derekfountain/z88-recreation/README.md

# z88-recreation
A recreation of the 1980's Z88 micro, using modern components
