derekfountain/z88-recreation/software/application-board/app-board-sh1106-pico2/README.md

# Application Board Pico2 Demo (SH1106 version)

A demonstration program for the application board, displays information on Pico2.

This assumes the Pico it's running on is connected to a SH1106-based OLED display.
