derekfountain/z88-recreation/software/application-board/app-board-demo-ssd1306-oled/README.md

# Application Board OLED Demo (SH1106 version)

A demonstration program for the application board.

This assumes the Pico it's running on is connected to
a SSD1306-based OLED display.

It turned out my displays are SH1106 based, so this code
was never used. I don't know if it works.
