derekfountain/z88-recreation/hardware/pcb/main-board/notebook.txt

This is the simulation of the dual shifts, RTC and
Pico latch inputs which power up the Pico's power circuit.
 
https://www.falstad.com/circuit/circuitjs.html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
