derekfountain/z88-recreation/documents/pcb_design/v1.0_block_design.pdf

Clicky beeper, proper audio is out via 3.5mm socket

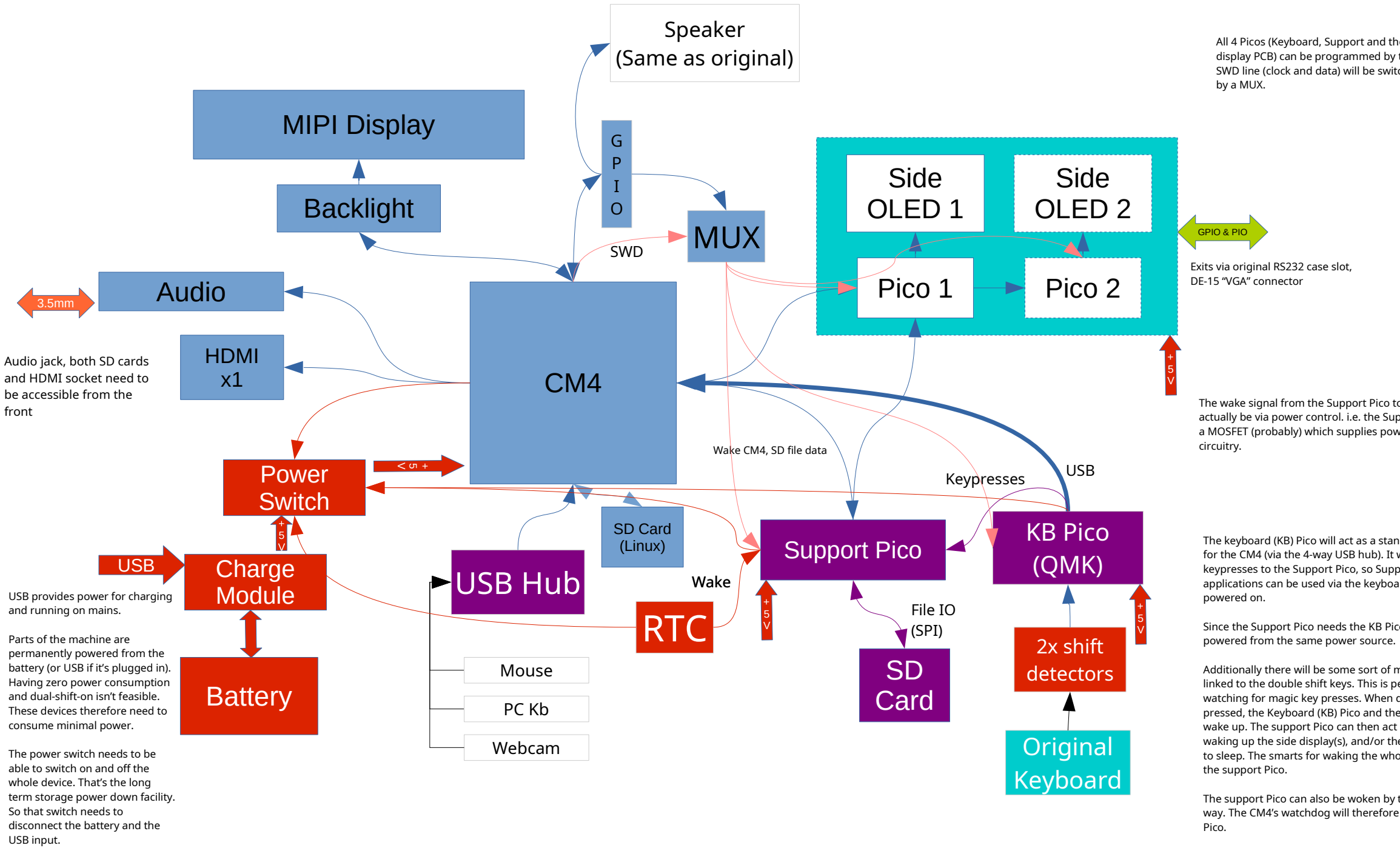
[picture p13: figure]
Support Pico; GPIO & PIO; Audio; SD Card; HDMI x1; Charge Module; USB; Battery; RTC; USB Hub; Original Keyboard; KB Pico (QMK); 2x shift detectors; Speaker (Same as original); Exits via original RS232 case slot, DE-15 “VGA” connector; USB provides power for charging and running on mains.; Parts of the machine are permanently powered from the battery (or USB if it’s plugged in). Having zero power consumption and dual-shift-on isn’t feasible. These devices therefore need to consume minimal power.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

All 4 Picos (Keyboard, Support and the optional 2 in the display PCB) can be programmed by the CM4 via SWD. The 2 SWD line (clock and data) will be switched one of four ways

The keyboard (KB) Pico will act as a standard USB keyboard for the CM4 (via the 4-way USB hub). It will also supply keypresses to the Support Pico, so Support Pico based applications can be used via the keyboard without the CM4

Since the Support Pico needs the KB Pico, they can be

Additionally there will be some sort of main power switch linked to the double shift keys. This is permanently powered, watching for magic key presses. When double shift is pressed, the Keyboard (KB) Pico and the Support Pico will wake up. The support Pico can then act as necessary, either waking up the side display(s), and/or the CM4, or going back to sleep. The smarts for waking the whole system up are in

The support Pico can also be woken by the RTC in the same way. The CM4’s watchdog will therefore be via the support

Red denotes permanent power. This comes from the USB connection or the battery, into the charge module. Real time clock and the dual shift detection is permanently powered.

Blue denotes CM4 power. These devices power up when the CM4 is in use.

Purple denotes Support Pico power. These devices power up when the support Pico is in use.

The wake signal from the Support Pico to the CM4 will actually be via power control. i.e. the Support Pico will switch a MOSFET (probably) which supplies power to the CM4
