derekfountain/z88-recreation/images/original/pcb_front_1.png

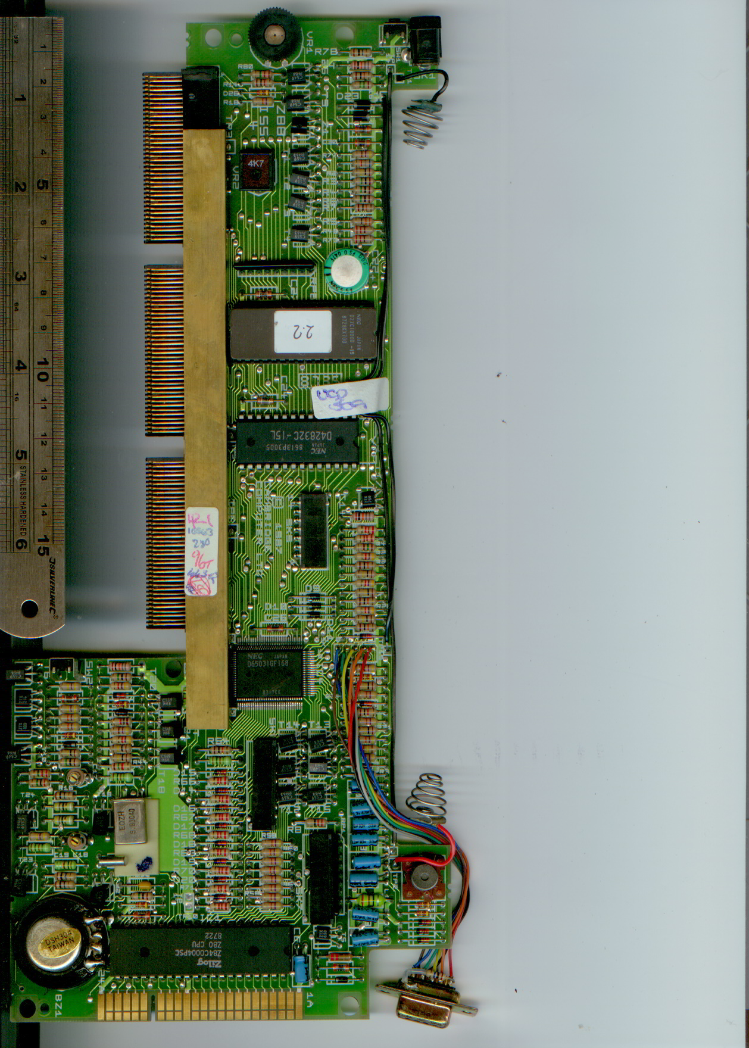
images/original/pcb_front_1.png
