derekfountain/z88-recreation/images/original/pcb_front_2.png

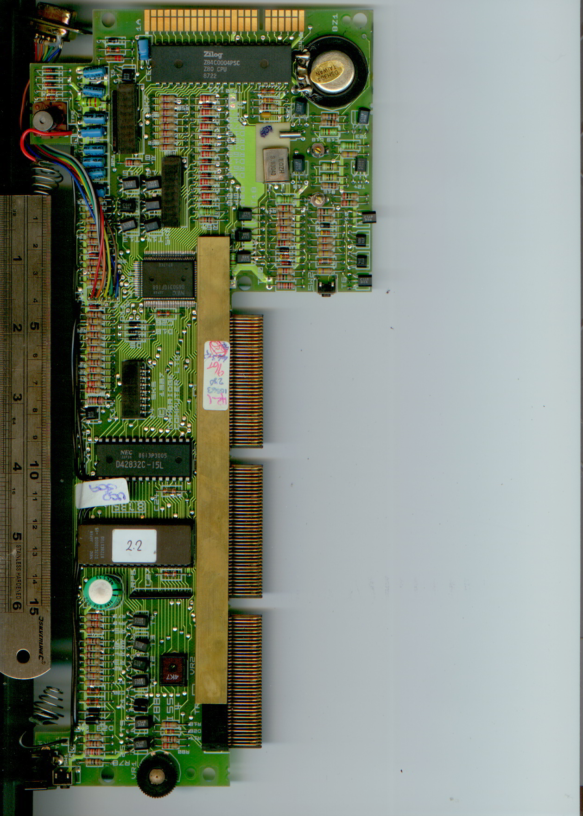
images/original/pcb_front_2.png
