derekfountain/z88-recreation/images/original/pcb_rear_1.png

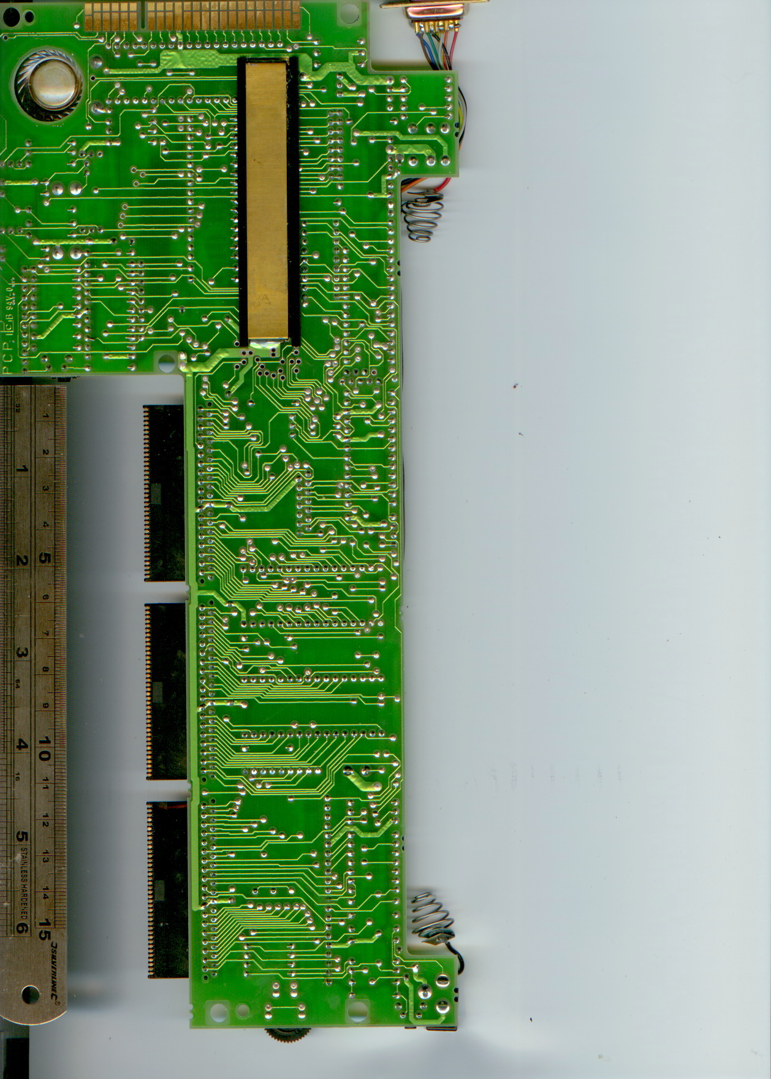
images/original/pcb_rear_1.png
