derekfountain/z88-recreation/images/original/pcb_rear_2.png

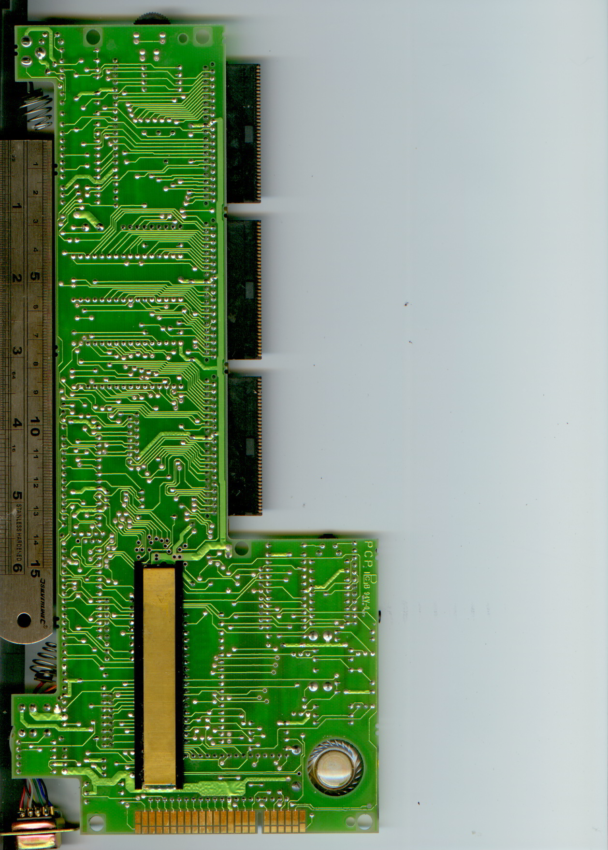
images/original/pcb_rear_2.png
