derekfountain/z88-recreation/images/v1.0/200_pin_connector.jpg

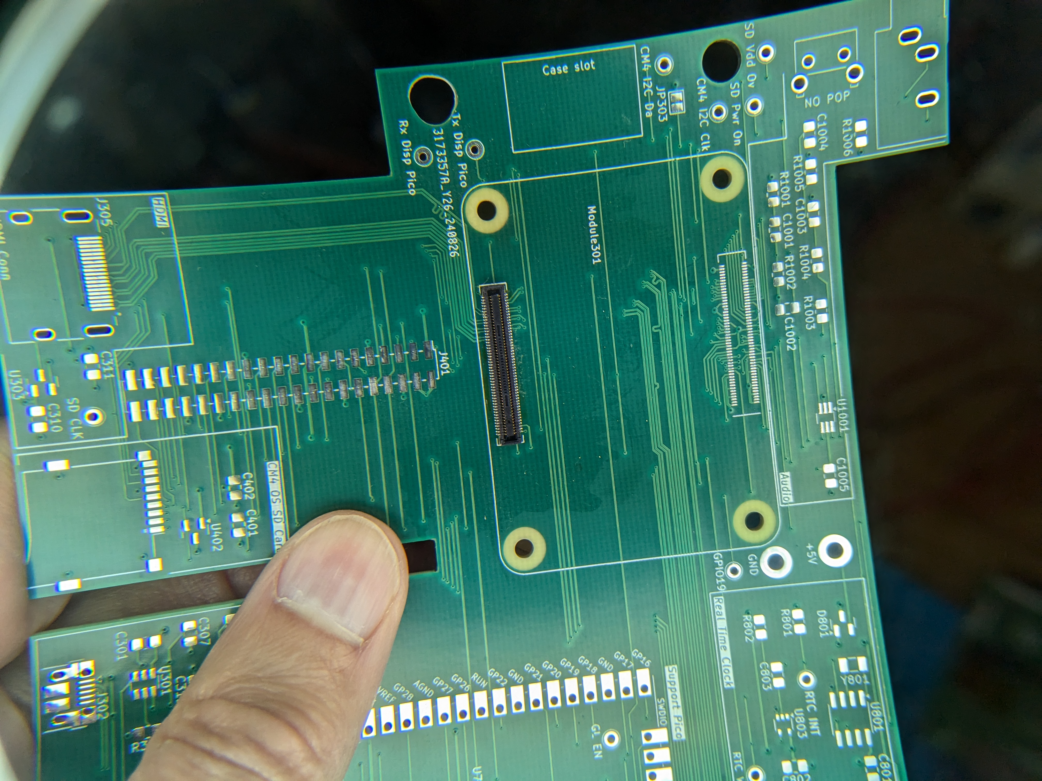
images/v1.0/200_pin_connector.jpg
