derekfountain/z88-recreation/images/v1.0/first_mipi.jpg

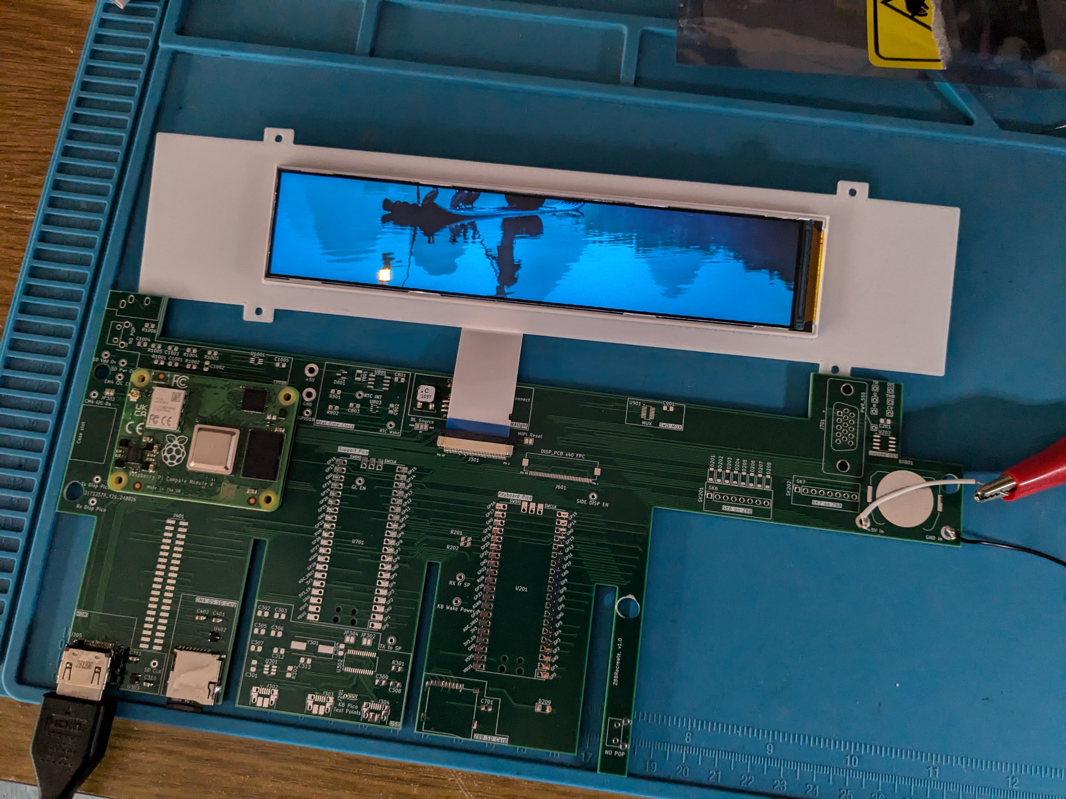
images/v1.0/first_mipi.jpg
