derekfountain/z88-recreation/images/v1.0/front_connectors.jpg

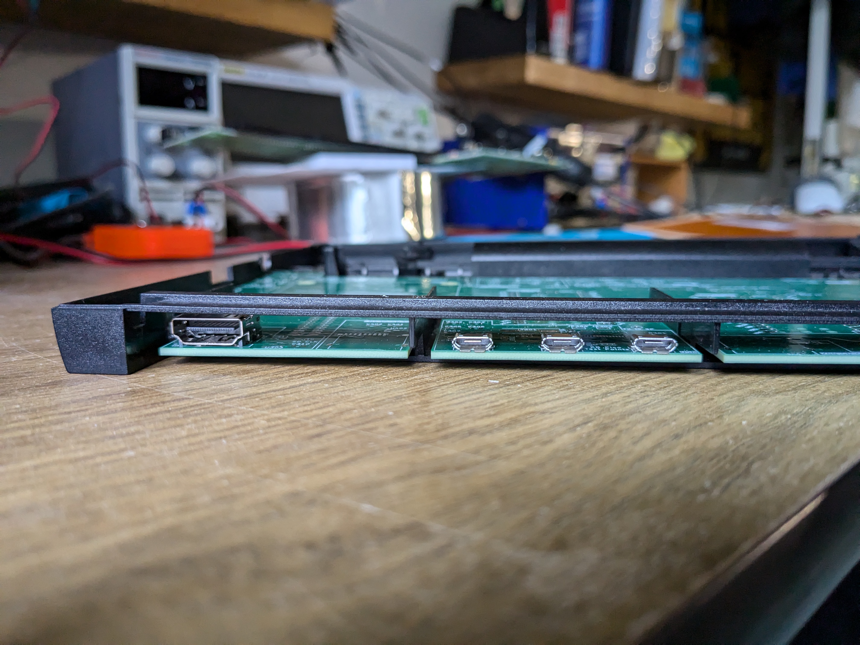
images/v1.0/front_connectors.jpg
