derekfountain/z88-recreation/images/v1.0/long_tail_membrane_in_place.jpg

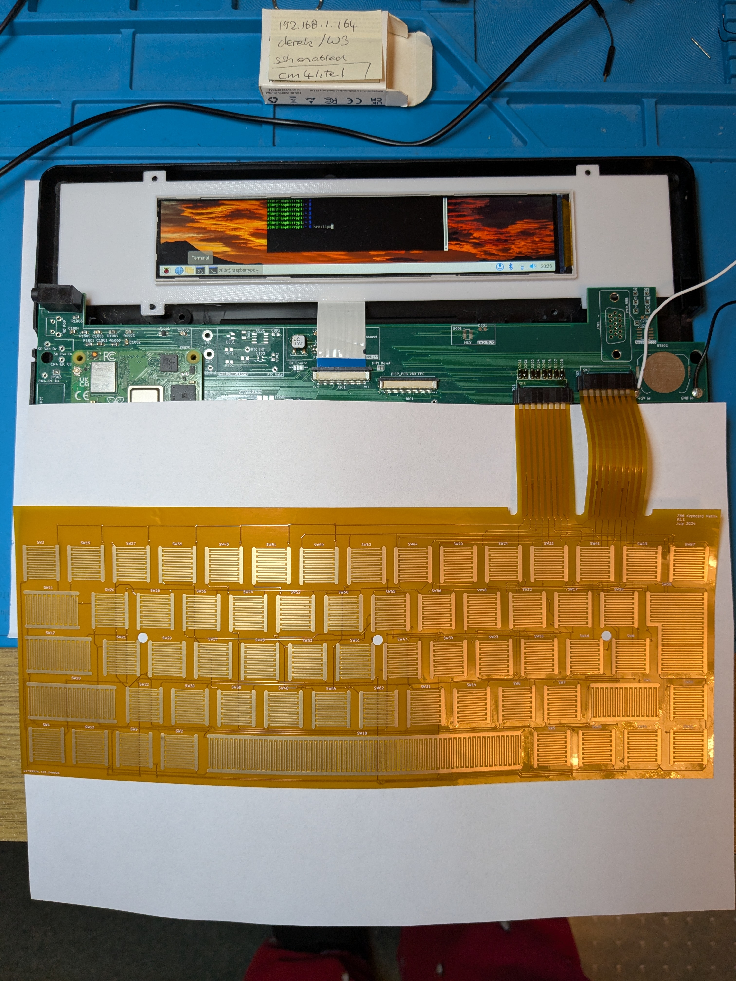
images/v1.0/long_tail_membrane_in_place.jpg
