derekfountain/z88-recreation/images/v1.0/mipi_with_new_bezel.jpg

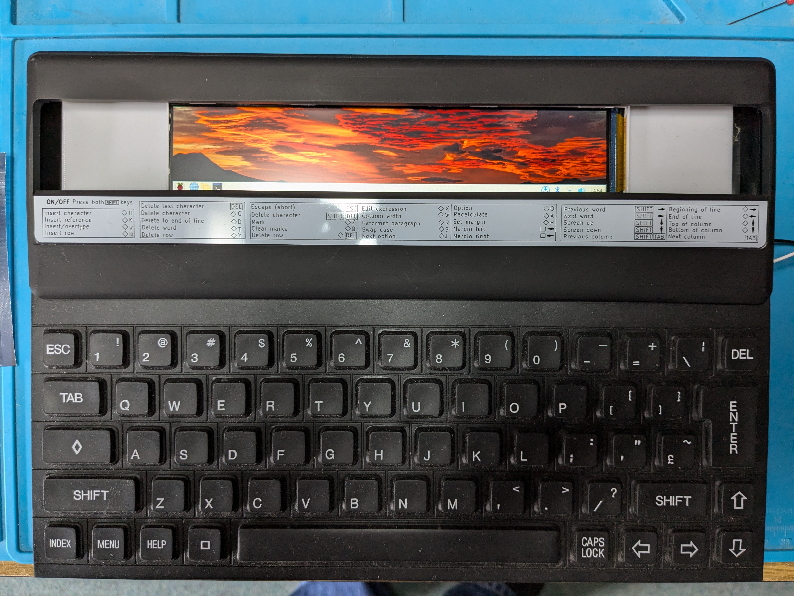
images/v1.0/mipi_with_new_bezel.jpg
