derekfountain/z88-recreation/images/v1.0/mipi_with_original_bezel.jpg

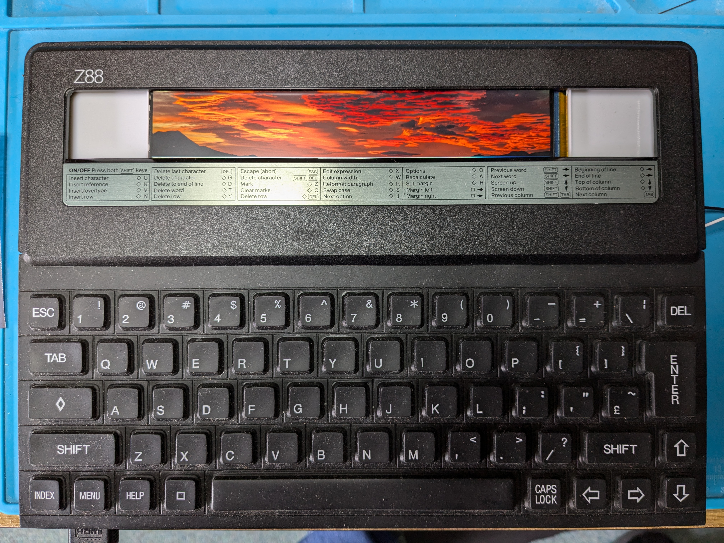
images/v1.0/mipi_with_original_bezel.jpg
