derekfountain/z88-recreation/images/v1.0/pico_in_place.jpg

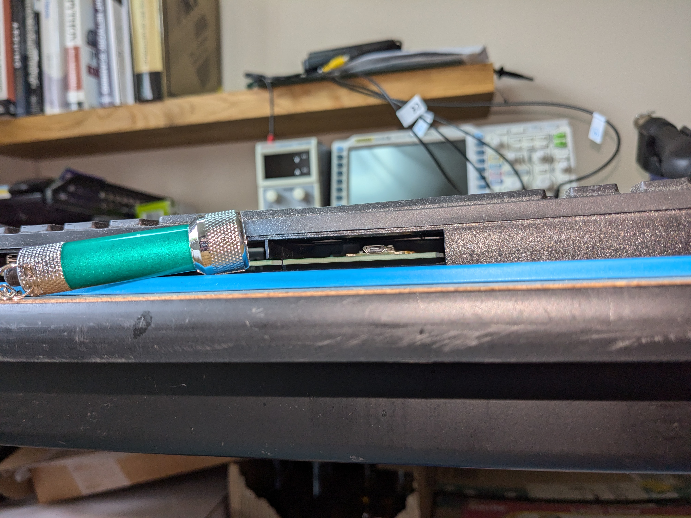
images/v1.0/pico_in_place.jpg
