derekfountain/z88-recreation/images/v1.0/v10_board_misalign_left.jpg

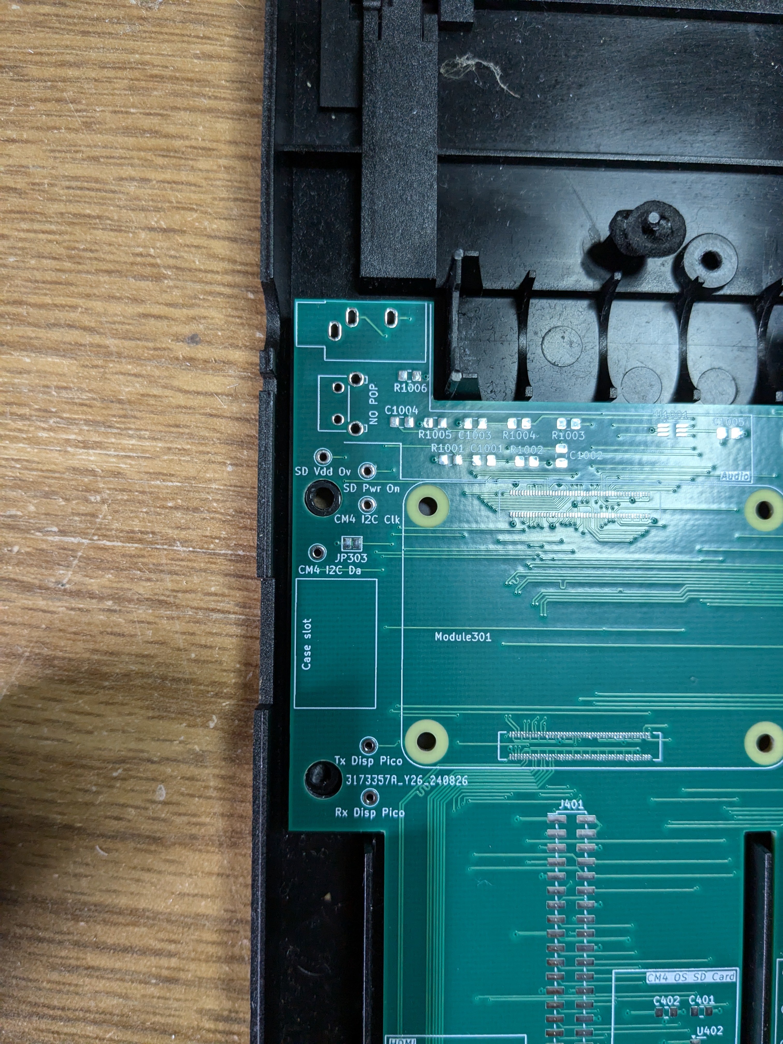
images/v1.0/v10_board_misalign_left.jpg
