derekfountain/z88-recreation/images/v1.0/v10_boards_packaged.jpg

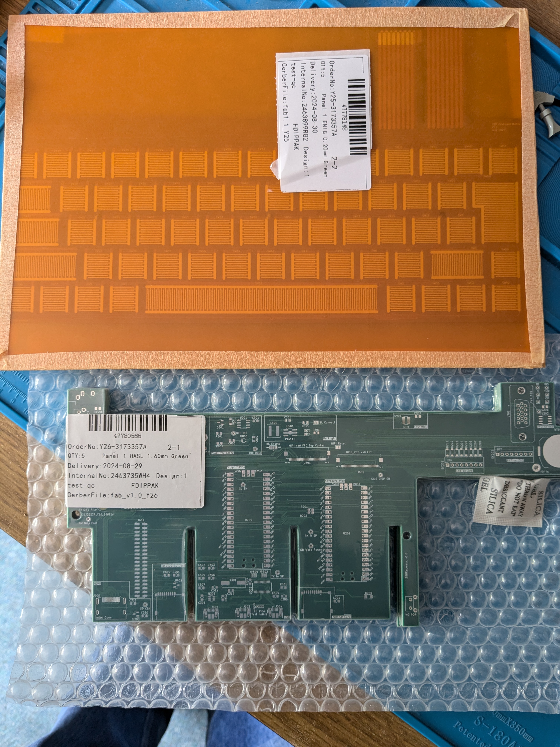
images/v1.0/v10_boards_packaged.jpg
