derekfountain/z88-recreation/images/v1.0/working_hdmi.jpg

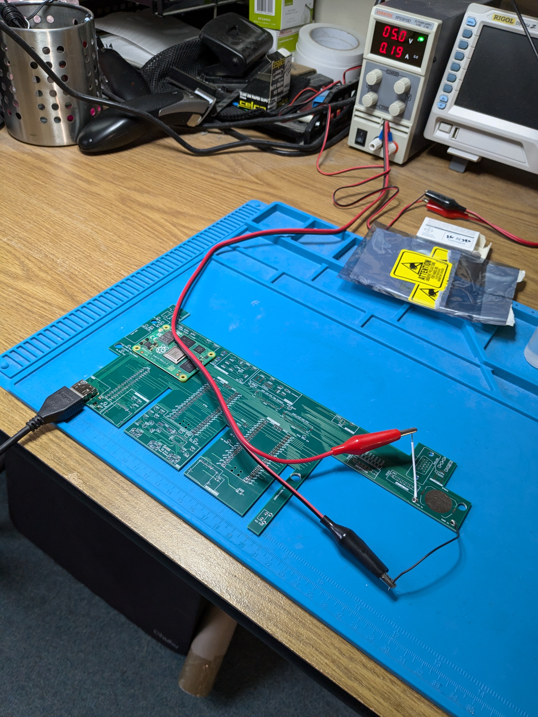
images/v1.0/working_hdmi.jpg
