derekfountain/z88-recreation/images/misc/am_cm4_display_order.png

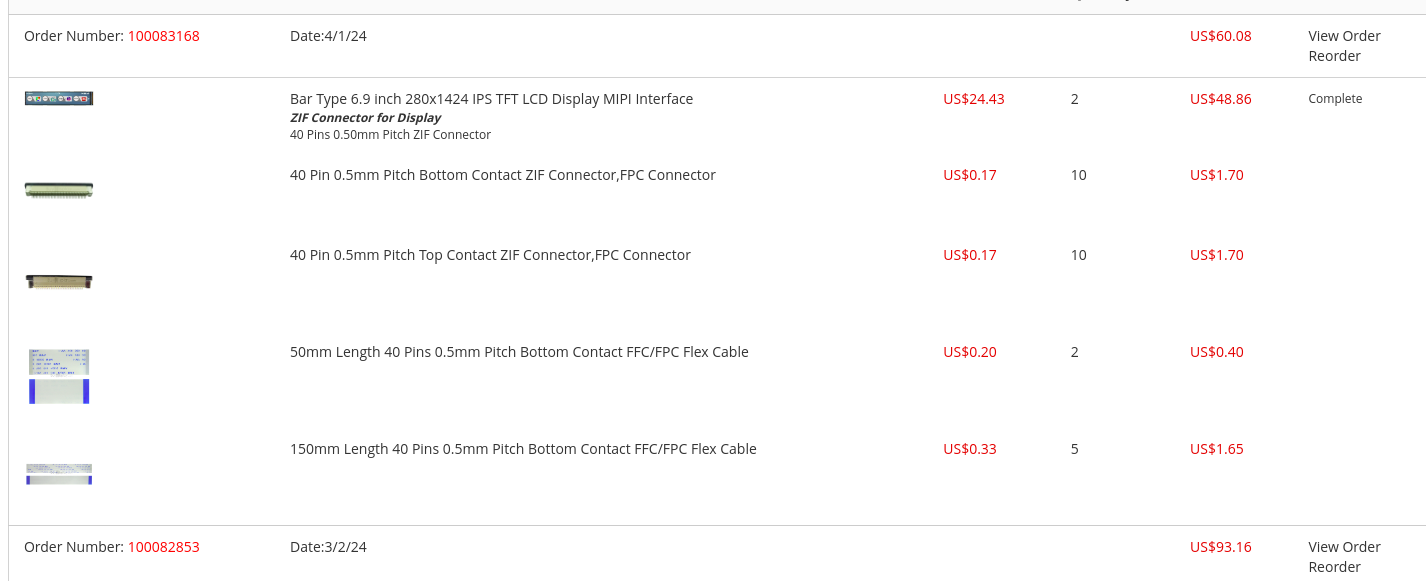
images/misc/am_cm4_display_order.png
