derekfountain/z88-recreation/images/misc/df_cm4_display_order.png

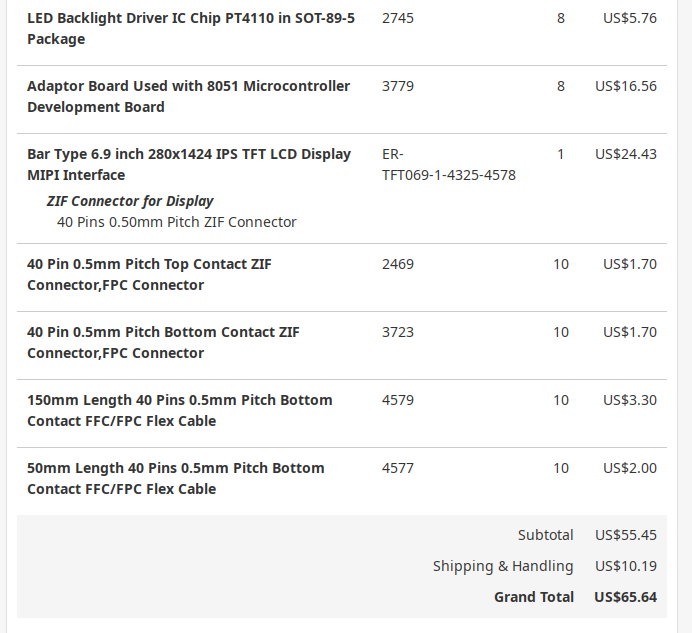
images/misc/df_cm4_display_order.png
