derekfountain/z88-recreation/3d_prints/application_board_mount/application_board_mount.3mf

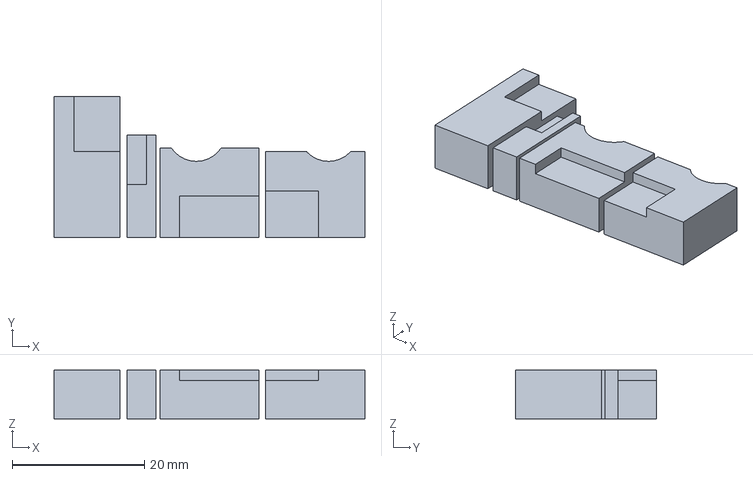
[picture p31: CAD file, 2026-01-27]
3d_prints/application_board_mount/application_board_mount.3mf
47.0 x 21.3 x 7.40 mm
