derekfountain/z88-recreation/3d_prints/battery_dummy/eemb/eemb_103395.stl

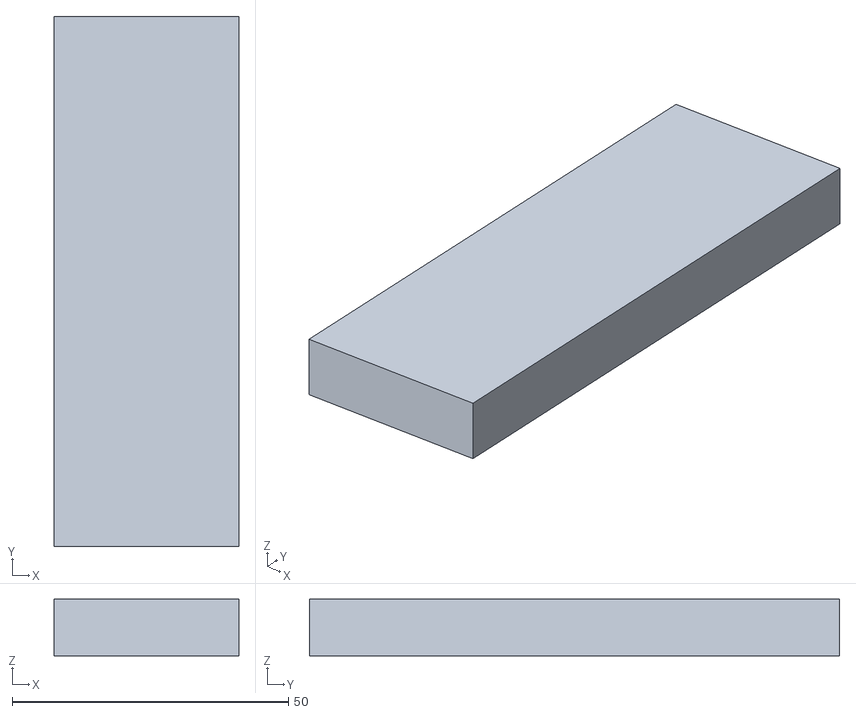
[picture p32: CAD file, 2025-11-17]
3d_prints/battery_dummy/eemb/eemb_103395.stl
33.5 x 96.0 x 10.3
