derekfountain/z88-recreation/3d_prints/display_mount/display_mount.3mf

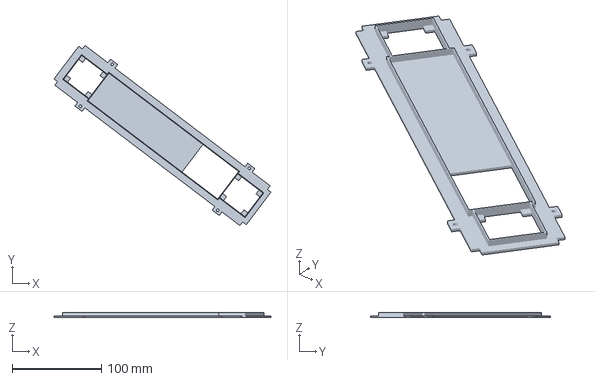
[picture p33: CAD file, 2025-11-17]
3d_prints/display_mount/display_mount.3mf
242.6 x 201.4 x 5.70 mm
