derekfountain/z88-recreation/3d_prints/display_mount_two_side_displays/display_mount_two_side_displays.3mf

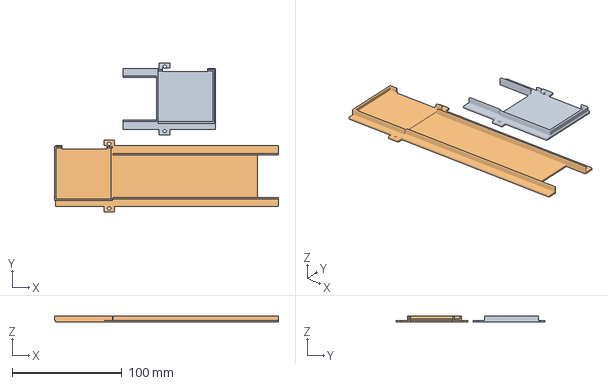
[picture p34: CAD file, 2025-11-17]
3d_prints/display_mount_two_side_displays/display_mount_two_side_displays.3mf
204.2 x 136.3 x 5.70 mm
display_mount_two_side_displays.stl x 2
