derekfountain/z88-recreation/3d_prints/new_bezel/new-bezel1.3mf

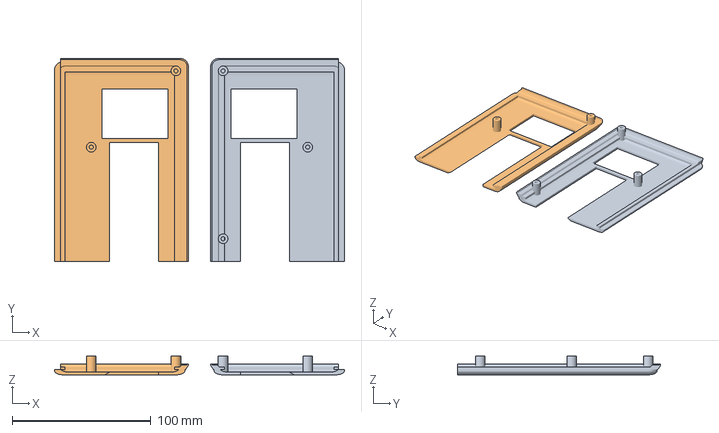
[picture p35: CAD file, 2025-11-17]
3d_prints/new_bezel/new-bezel1.3mf
209.0 x 146.5 x 13.4 mm
new-bezel1.stl x 2
