derekfountain/z88-recreation/3d_prints/side_display_bezel/1.3inch/bottom_bezel_1_3i.3mf

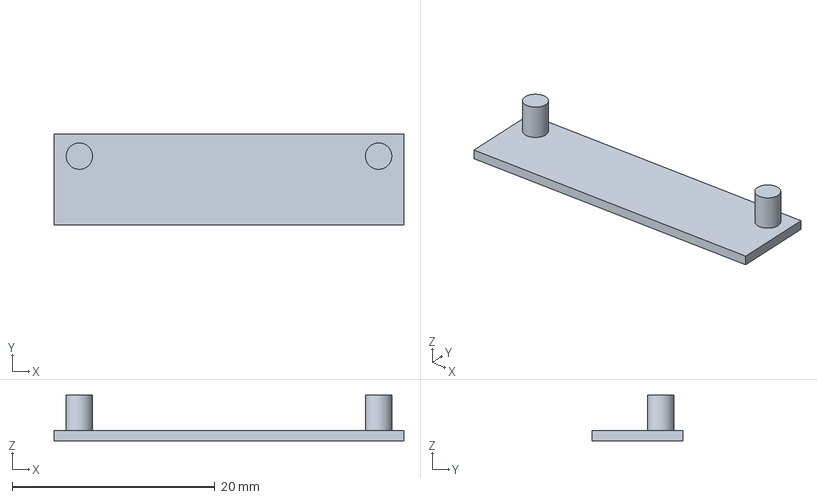
[picture p36: CAD file, 2026-02-04]
3d_prints/side_display_bezel/1.3inch/bottom_bezel_1_3i.3mf
34.5 x 9.00 x 4.50 mm
