derekfountain/z88-recreation/hardware/pcb/main-board/NC7WZ16P6X/NC7WZ16P6X.step

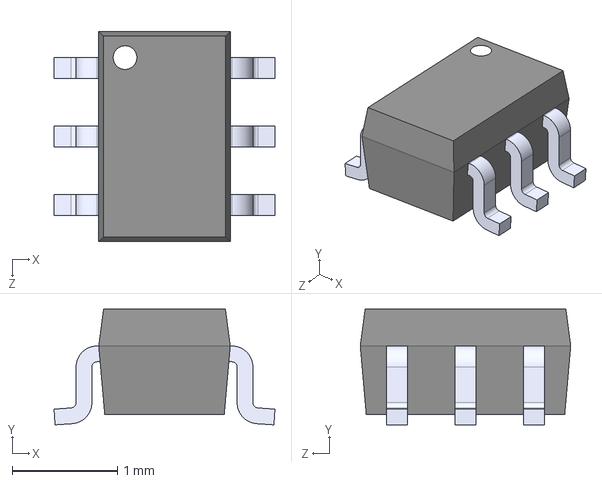
[picture p37: CAD file, 2025-11-17]
hardware/pcb/main-board/NC7WZ16P6X/NC7WZ16P6X.step
2.10 x 1.10 x 2.00 mm
