derekfountain/z88-recreation/3d_prints/battery_dummy/eemb/eemb_675776.stl

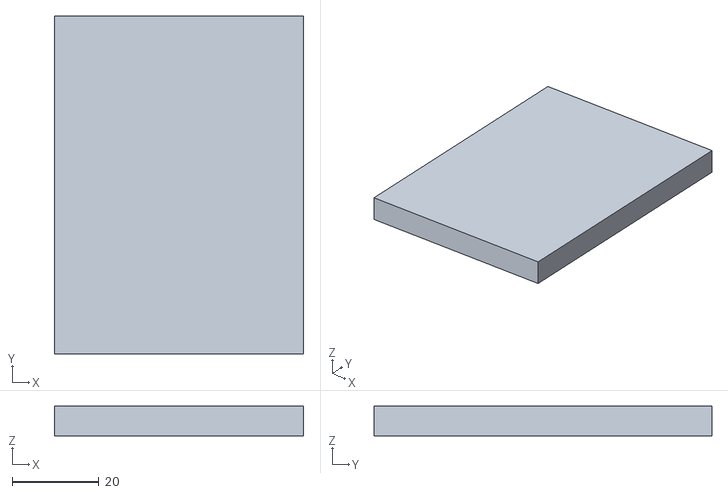
[picture p38: CAD file, 2025-11-17]
3d_prints/battery_dummy/eemb/eemb_675776.stl
57.5 x 78.0 x 6.90
