derekfountain/z88-recreation/3d_prints/side_display_bezel/1.3inch/top_bezel_1_3i.3mf

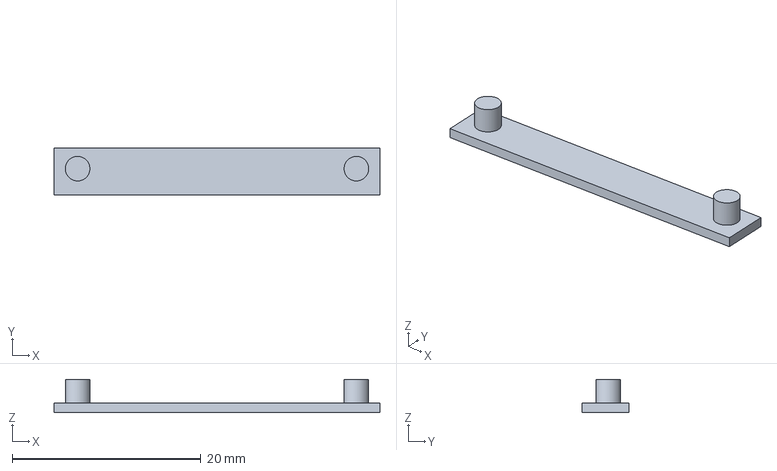
[picture p39: CAD file, 2026-02-04]
3d_prints/side_display_bezel/1.3inch/top_bezel_1_3i.3mf
34.5 x 5.00 x 3.50 mm
