derekfountain/z88-recreation/3d_prints/battery_dummy/eemb/eemb.scad

// This is the ideal battery, but it's *just* too tall
// https://www.amazon.co.uk/EEMB-Rechargeable-Replacement-103395-Connector/dp/B08215B4KK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
// cube( [33.5, 96, 10.3mm] );

// Smaller, smaller capacity, but it will fit
// https://www.amazon.co.uk/EEMB-Battery-rechargeable-Connector-Certified/dp/B09DPR4V6L?ref_=ast_sto_dp&th=1
cube( [57.5, 78, 6.9] );
