derekfountain/z88-recreation/3d_prints/side_display_bezel/1.3inch/bottom_bezel_1_3i.scad

// Small bezel piece to cover the bottom part of the 1.3" side screen
 
$fn=64;

width        = 34.5;
depth        = 9.0;
thickness    = 1.0;

peg_height   = 3.5;
peg_diameter = 2.6;
peg_radius   = peg_diameter/2;

peg_top_offset  = 0.9;
peg_side_offset = 1.2;

cube([width, depth, thickness]);

translate([peg_side_offset+peg_radius, depth-peg_top_offset-peg_radius, thickness])
  cylinder( h=peg_height, d=peg_diameter );
translate([width-peg_side_offset-peg_radius, depth-peg_top_offset-peg_radius, thickness])
  cylinder( h=peg_height, d=peg_diameter );  
