derekfountain/z88-recreation/(list of files, cad)

Other CAD files:
3d_prints/display_mount_two_side_displays/display_mount_two_side_displays.scad
3d_prints/side_display_bezel/1.3inch/top_bezel_1_3i.scad
3d_prints/application_board_mount/application_board_mount.stl
3d_prints/display_mount/display_mount.stl
3d_prints/display_mount_two_side_displays/display_mount_two_side_displays.stl
3d_prints/new_bezel/new-bezel1.stl
3d_prints/side_display_bezel/1.3inch/bottom_bezel_1_3i.stl
3d_prints/side_display_bezel/1.3inch/top_bezel_1_3i.stl
