derekfountain/z88-recreation/3d_prints/side_display_bezel/1.3inch/README.md

# 1.3" side screen top bezel

A small cover to fit over the top of the 1.3" OLED display
used for a side screen.

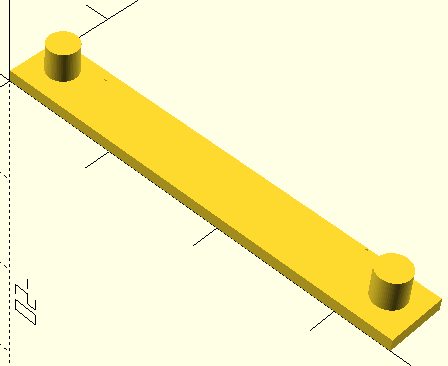
[picture p40: 3d_prints/side_display_bezel/1.3inch/top_bezel.png]
Bezel
