derekfountain/z88-recreation/documents/service_manual/fig16.png

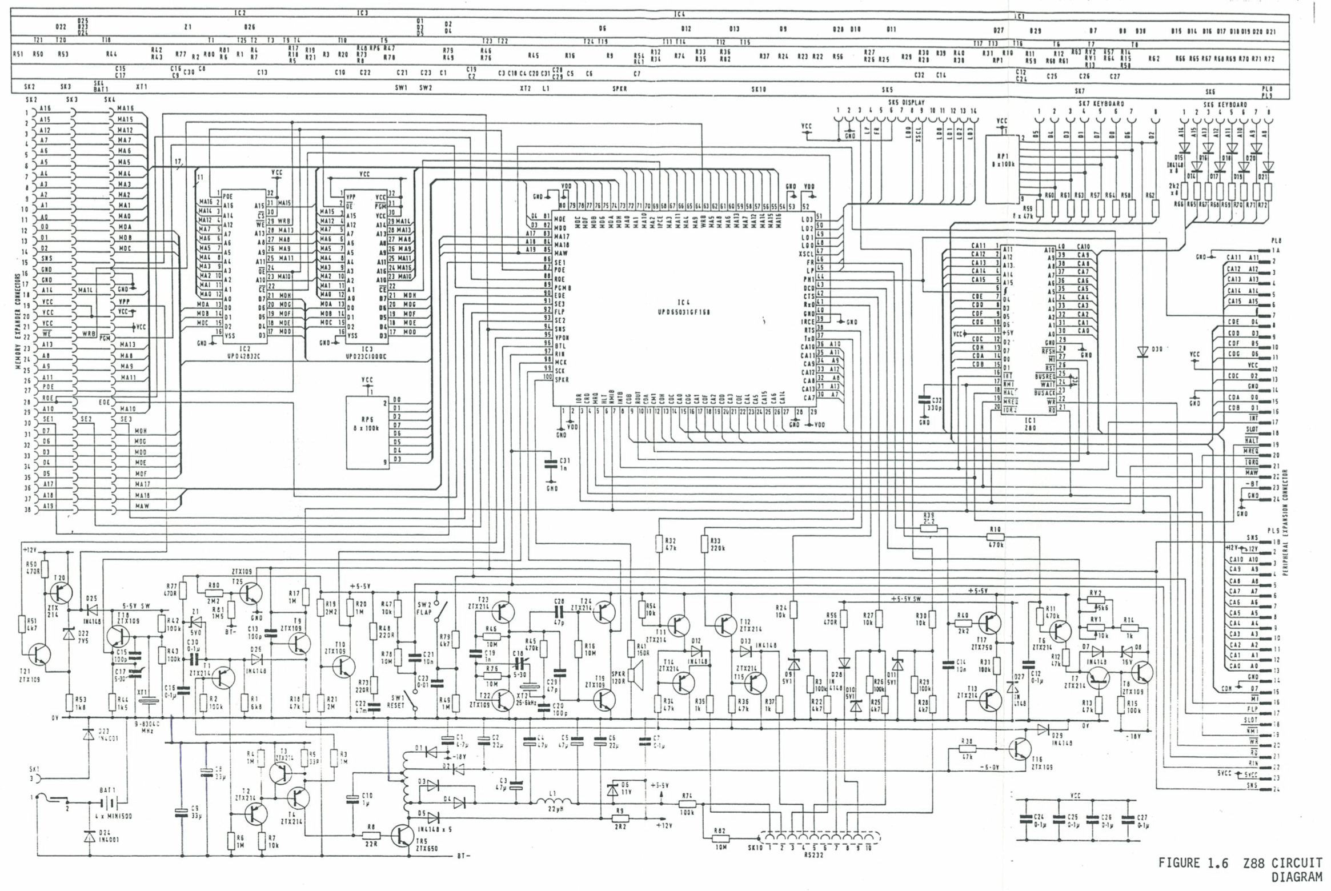
documents/service_manual/fig16.png
