derekfountain/z88-recreation/images/original/screen_measure_width.jpg

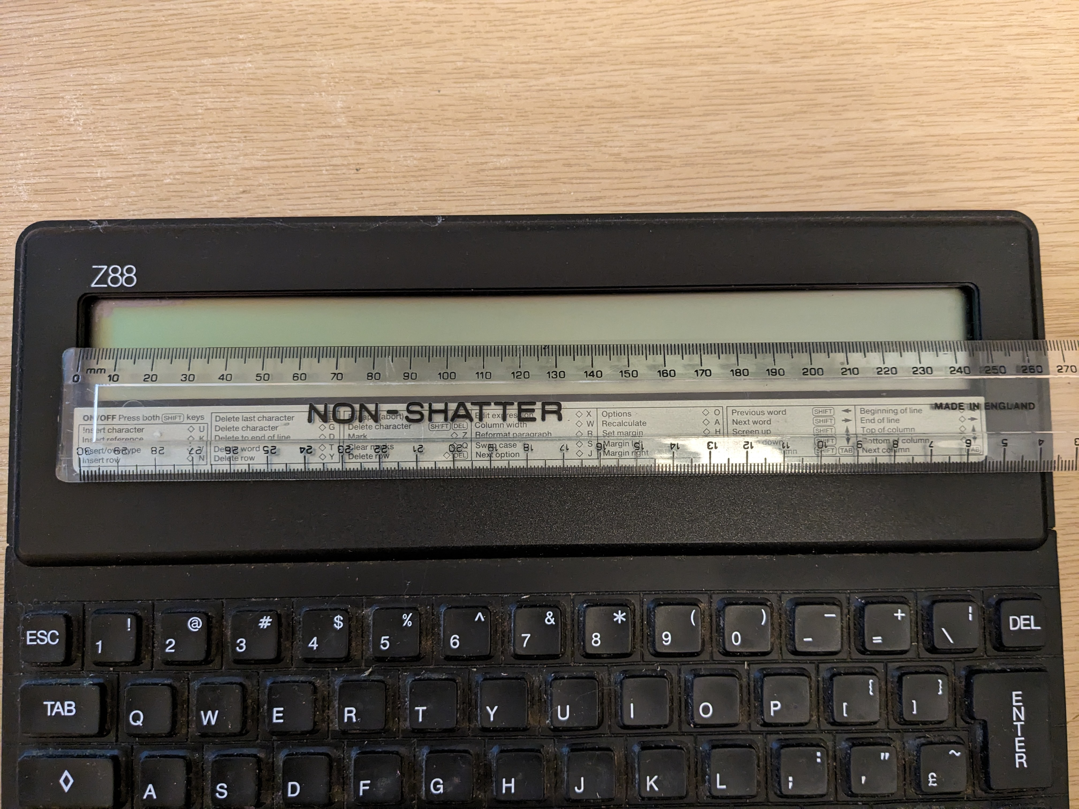
images/original/screen_measure_width.jpg
