derekfountain/z88-recreation/hardware/pcb/application-board/app_board.kicad_pcb

## KiCad design hardware/pcb/application-board/app_board.kicad_pcb (2026-01-04)

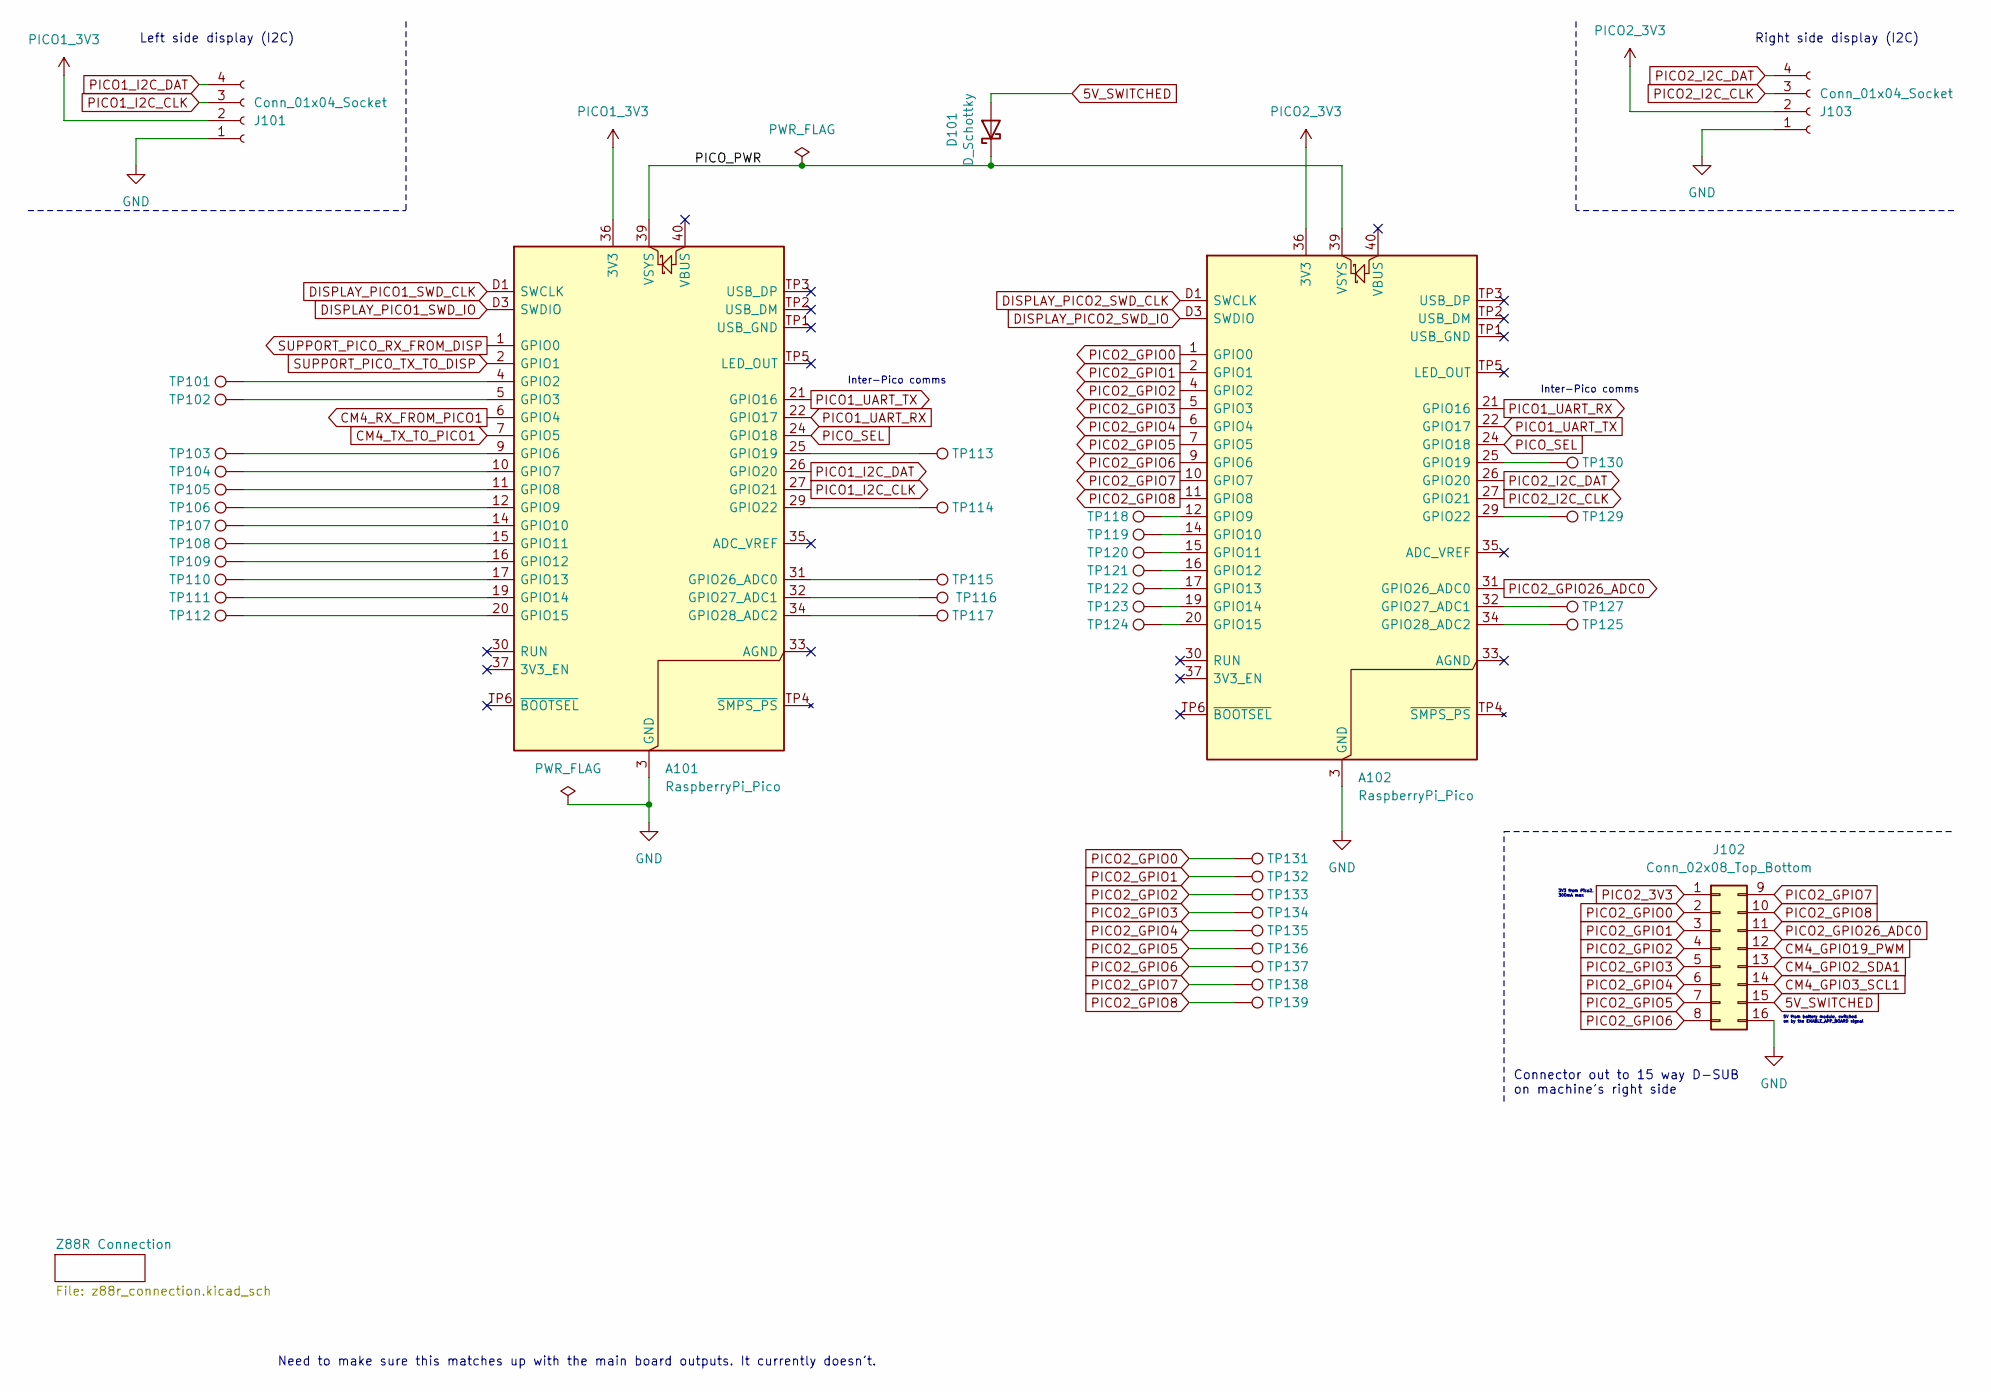
[picture p43: schematic app_board.kicad_sch, Z88 Recreation Application Board]

Parts:
A101, A102: RaspberryPi_Pico; RaspberryPi_Pico_Original_SMD
D101: D_Schottky; D_1206_3216Metric_Pad1.42x1.75mm_HandSolder
J101, J103: Conn_01x04_Socket; PinHeader_1x04_P2.54mm_Vertical
J102: Conn_02x08_Top_Bottom; PinHeader_2x08_P2.54mm_Vertical
TP101, TP102, TP103, TP104, TP105, TP106, TP107, TP108, TP109, TP110, TP111, TP112, TP113, TP114, TP115, TP116, TP117, TP118, TP119, TP120, TP121, TP122, TP123, TP124, TP125, TP127, TP129, TP130, TP131, TP132, TP133, TP134, TP135, TP136, TP137, TP138, TP139: TestPoint; TestPoint_THTPad_D2.0mm_Drill1.0mm

Connections:
5V_SWITCHED: D101.2 (A), J102.15; also elsewhere on the board
/PICO_PWR: A101.39 (VSYS), A102.39 (VSYS), D101.1 (K)
CM4_GPIO2_SDA1: J102.13; also elsewhere on the board
CM4_GPIO3_SCL1: J102.14; also elsewhere on the board
CM4_GPIO19_PWM: J102.12; also elsewhere on the board
CM4_RX_FROM_PICO1: A101.6 (GPIO4); also elsewhere on the board
CM4_TX_TO_PICO1: A101.7 (GPIO5); also elsewhere on the board
DISPLAY_PICO1_SWD_CLK: A101.D1 (SWCLK); also elsewhere on the board
DISPLAY_PICO1_SWD_IO: A101.D3 (SWDIO); also elsewhere on the board
DISPLAY_PICO2_SWD_CLK: A102.D1 (SWCLK); also elsewhere on the board
DISPLAY_PICO2_SWD_IO: A102.D3 (SWDIO); also elsewhere on the board
GND: A101.3 (GND), A101.8 (GND), A101.13 (GND), A101.18 (GND), A101.23 (GND), A101.28 (GND), A101.38 (GND), A101.D2 (GND), A102.3 (GND), A102.8 (GND), A102.13 (GND), A102.18 (GND), A102.23 (GND), A102.28 (GND), A102.38 (GND), A102.D2 (GND), J101.1, J102.16, J103.1; also elsewhere on the board
unnamed: A101.4 (GPIO2), TP101.1
unnamed: A101.5 (GPIO3), TP102.1
unnamed: A101.9 (GPIO6), TP103.1
unnamed: A101.10 (GPIO7), TP104.1
unnamed: A101.11 (GPIO8), TP105.1
unnamed: A101.12 (GPIO9), TP106.1
unnamed: A101.14 (GPIO10), TP107.1
unnamed: A101.15 (GPIO11), TP108.1
unnamed: A101.16 (GPIO12), TP109.1
unnamed: A101.17 (GPIO13), TP110.1
unnamed: A101.19 (GPIO14), TP111.1
unnamed: A101.20 (GPIO15), TP112.1
unnamed: A101.25 (GPIO19), TP113.1
unnamed: A101.29 (GPIO22), TP114.1
unnamed: A101.31 (GPIO26_ADC0), TP115.1
unnamed: A101.32 (GPIO27_ADC1), TP116.1
unnamed: A101.34 (GPIO28_ADC2), TP117.1
unnamed: A102.12 (GPIO9), TP118.1
unnamed: A102.14 (GPIO10), TP119.1
unnamed: A102.15 (GPIO11), TP120.1
unnamed: A102.16 (GPIO12), TP121.1
unnamed: A102.17 (GPIO13), TP122.1
unnamed: A102.19 (GPIO14), TP123.1
unnamed: A102.20 (GPIO15), TP124.1
unnamed: A102.25 (GPIO19), TP130.1
unnamed: A102.29 (GPIO22), TP129.1
unnamed: A102.32 (GPIO27_ADC1), TP127.1
unnamed: A102.34 (GPIO28_ADC2), TP125.1
PICO1_3V3: A101.36 (3V3), J101.2
PICO1_I2C_CLK: A101.27 (GPIO21), J101.3
PICO1_I2C_DAT: A101.26 (GPIO20), J101.4
PICO1_UART_RX: A101.22 (GPIO17), A102.21 (GPIO16)
PICO1_UART_TX: A101.21 (GPIO16), A102.22 (GPIO17)
PICO2_3V3: A102.36 (3V3), J102.1, J103.2
PICO2_GPIO0: A102.1 (GPIO0), J102.2, TP131.1
PICO2_GPIO1: A102.2 (GPIO1), J102.3, TP132.1
PICO2_GPIO2: A102.4 (GPIO2), J102.4, TP133.1
PICO2_GPIO3: A102.5 (GPIO3), J102.5, TP134.1
PICO2_GPIO4: A102.6 (GPIO4), J102.6, TP135.1
PICO2_GPIO5: A102.7 (GPIO5), J102.7, TP136.1
PICO2_GPIO6: A102.9 (GPIO6), J102.8, TP137.1
PICO2_GPIO7: A102.10 (GPIO7), J102.9, TP138.1
PICO2_GPIO8: A102.11 (GPIO8), J102.10, TP139.1
PICO2_GPIO26_ADC0: A102.31 (GPIO26_ADC0), J102.11
PICO2_I2C_CLK: A102.27 (GPIO21), J103.3
PICO2_I2C_DAT: A102.26 (GPIO20), J103.4
PICO_SEL: A101.24 (GPIO18), A102.24 (GPIO18); also elsewhere on the board
SUPPORT_PICO_RX_FROM_DISP: A101.1 (GPIO0); also elsewhere on the board
SUPPORT_PICO_TX_TO_DISP: A101.2 (GPIO1); also elsewhere on the board

Notes on the sheet:
3V3 from Pico2, 300mA max
Connector out to 15 way D-SUB on machine's right side
Right side display (I2C)
5V from battery module, switched on by the ENABLE_APP_BOARD signal
Inter-Pico comms
Need to make sure this matches up with the main board outputs. It currently doesn't.
Left side display (I2C)

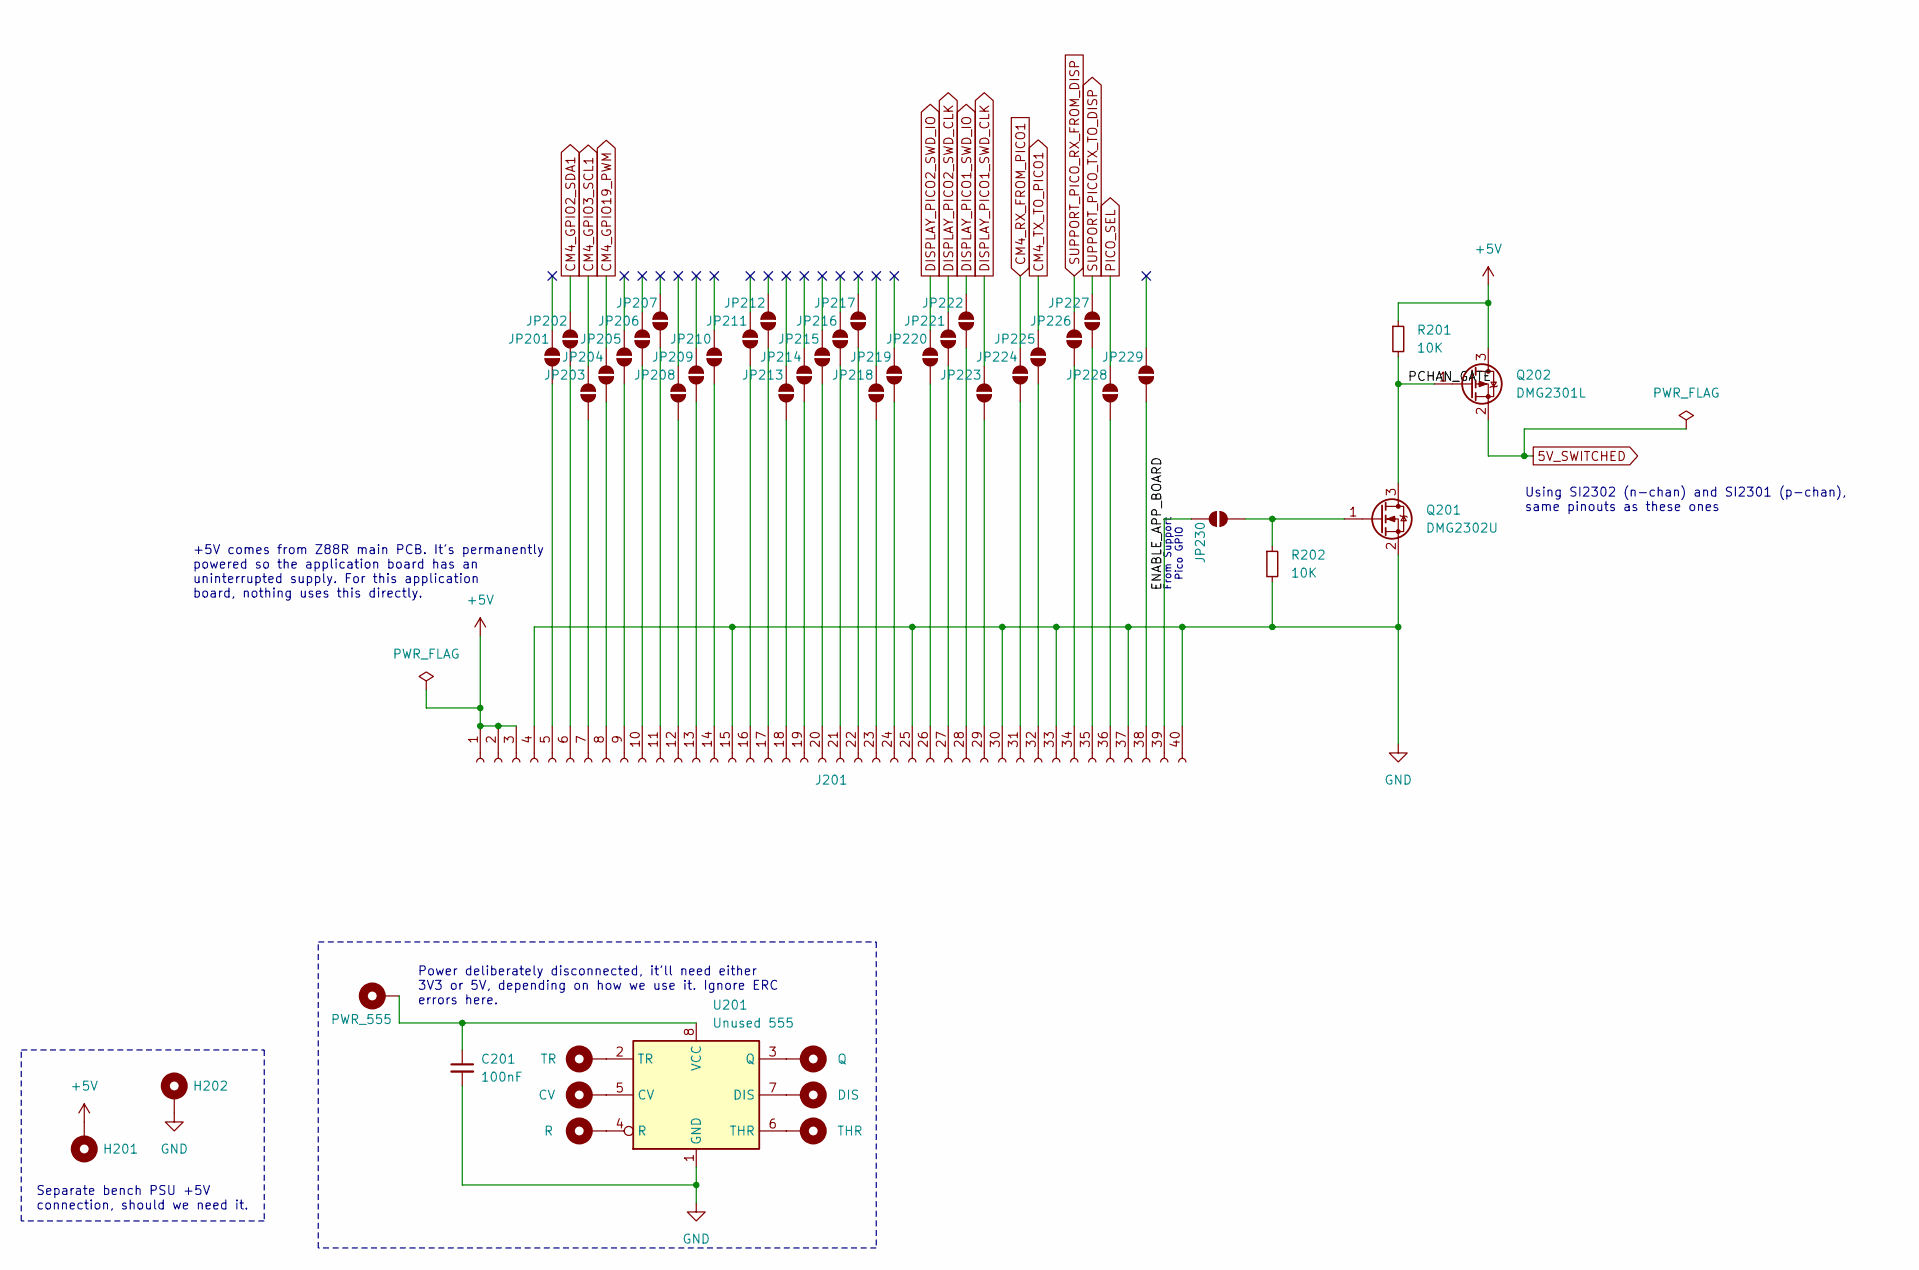
[picture p44: schematic z88r_connection.kicad_sch, Z88 Recreation Application Board]

Parts:
C201: 100nF; C_0805_2012Metric_Pad1.18x1.45mm_HandSolder
H201: +5V; MountingHole_2.2mm_M2_Pad
H202: GND; MountingHole_2.2mm_M2_Pad
H203: PWR_555; Pin_D0.7mm_L6.5mm_W1.8mm_FlatFork
H204: TR; Pin_D0.7mm_L6.5mm_W1.8mm_FlatFork
H205: CV; Pin_D0.7mm_L6.5mm_W1.8mm_FlatFork
H206: R; Pin_D0.7mm_L6.5mm_W1.8mm_FlatFork
H207: Q; Pin_D0.7mm_L6.5mm_W1.8mm_FlatFork
H208: DIS; Pin_D0.7mm_L6.5mm_W1.8mm_FlatFork
H209: THR; Pin_D0.7mm_L6.5mm_W1.8mm_FlatFork
J201: DISP_PCB x40 FPC; Hirose_FH12-40S-0.5SH_1x40-1MP_P0.50mm_Horizontal
JP201, JP202, JP203, JP204, JP205, JP206, JP207, JP208, JP209, JP210, JP211, JP212, JP213, JP214, JP215, JP216, JP217, JP218, JP219, JP220, JP221, JP222, JP223, JP224, JP225, JP226, JP227, JP228, JP229, JP230: SolderJumper_2_Open; SolderJumper-2_P1.3mm_Open_Pad1.0x1.5mm
Q201: DMG2302U; SOT-23
Q202: DMG2301L; SOT-23
R201, R202: 10K; R_0805_2012Metric_Pad1.20x1.40mm_HandSolder
U201: Unused 555; SOIC-8_3.9x4.9mm_P1.27mm

Connections:
5V_SWITCHED: Q202.2 (S); also elsewhere on the board
+5V: H201.1, J201.1, J201.2, J201.3, Q202.3 (D), R201.1
/Z88R Connection/ENABLE_APP_BOARD: J201.39, JP230.2 (B)
/Z88R Connection/PCHAN_GATE: Q201.3 (D), Q202.1 (G), R201.2
CM4_GPIO2_SDA1: JP202.2 (B); also elsewhere on the board
CM4_GPIO3_SCL1: JP203.2 (B); also elsewhere on the board
CM4_GPIO19_PWM: JP204.2 (B); also elsewhere on the board
CM4_RX_FROM_PICO1: JP224.2 (B); also elsewhere on the board
CM4_TX_TO_PICO1: JP225.2 (B); also elsewhere on the board
DISPLAY_PICO1_SWD_CLK: JP223.2 (B); also elsewhere on the board
DISPLAY_PICO1_SWD_IO: JP222.2 (B); also elsewhere on the board
DISPLAY_PICO2_SWD_CLK: JP221.2 (B); also elsewhere on the board
DISPLAY_PICO2_SWD_IO: JP220.2 (B); also elsewhere on the board
GND: C201.2, H202.1, J201.4, J201.15, J201.25, J201.30, J201.33, J201.37, J201.40, Q201.2 (S), R202.2, U201.1 (GND); also elsewhere on the board
unnamed: J201.5, JP201.1 (A)
unnamed: J201.6, JP202.1 (A)
unnamed: J201.7, JP203.1 (A)
unnamed: J201.8, JP204.1 (A)
unnamed: J201.9, JP205.1 (A)
unnamed: J201.10, JP206.1 (A)
unnamed: J201.11, JP207.1 (A)
unnamed: J201.12, JP208.1 (A)
unnamed: J201.13, JP209.1 (A)
unnamed: J201.14, JP210.1 (A)
unnamed: J201.16, JP211.1 (A)
unnamed: J201.17, JP212.1 (A)
unnamed: J201.18, JP213.1 (A)
unnamed: J201.19, JP214.1 (A)
unnamed: J201.20, JP215.1 (A)
unnamed: J201.21, JP216.1 (A)
unnamed: J201.22, JP217.1 (A)
unnamed: J201.23, JP218.1 (A)
unnamed: J201.24, JP219.1 (A)
unnamed: J201.26, JP220.1 (A)
unnamed: J201.27, JP221.1 (A)
unnamed: J201.28, JP222.1 (A)
unnamed: J201.29, JP223.1 (A)
unnamed: J201.31, JP224.1 (A)
unnamed: J201.32, JP225.1 (A)
unnamed: J201.34, JP226.1 (A)
unnamed: J201.35, JP227.1 (A)
unnamed: J201.36, JP228.1 (A)
unnamed: J201.38, JP229.1 (A)
unnamed: JP230.1 (A), Q201.1 (G), R202.1
unnamed: H205.1, U201.5 (CV)
unnamed: H208.1, U201.7 (DIS)
unnamed: H207.1, U201.3 (Q)
unnamed: H206.1, U201.4 (R)
unnamed: H209.1, U201.6 (THR)
unnamed: H204.1, U201.2 (TR)
unnamed: C201.1, H203.1, U201.8 (VCC)
PICO_SEL: JP228.2 (B); also elsewhere on the board
SUPPORT_PICO_RX_FROM_DISP: JP226.2 (B); also elsewhere on the board
SUPPORT_PICO_TX_TO_DISP: JP227.2 (B); also elsewhere on the board

Notes on the sheet:
Separate bench PSU +5V connection, should we need it.
Using SI2302 (n-chan) and SI2301 (p-chan), same pinouts as these ones
Power deliberately disconnected, it'll need either 3V3 or 5V, depending on how we use it. Ignore ERC errors here.
+5V comes from Z88R main PCB. It's permanently powered so the application board has an uninterrupted supply. For this application board, nothing uses this directly.
From Support Pico GPIO

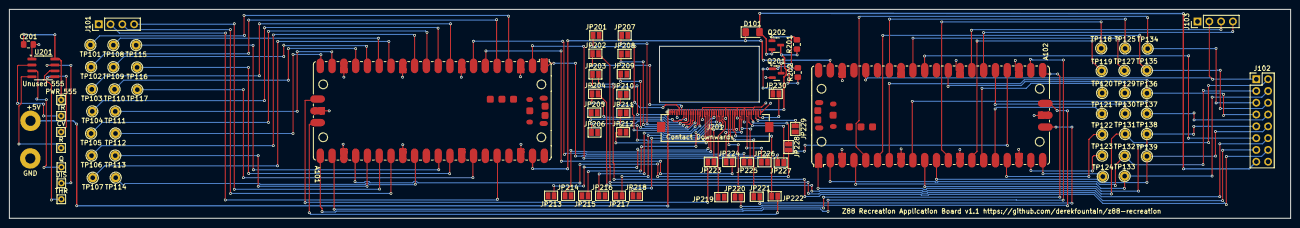
[picture p45: board app_board.kicad_pcb from above]

Board: 2 copper layers, 276.0 x 45.0 mm, 89 parts (0 on the bottom side), 101 nets.
