derekfountain/z88-recreation/hardware/pcb/main-board/z88_new.kicad_pcb

## KiCad design hardware/pcb/main-board/z88_new.kicad_pcb (2025-11-17)

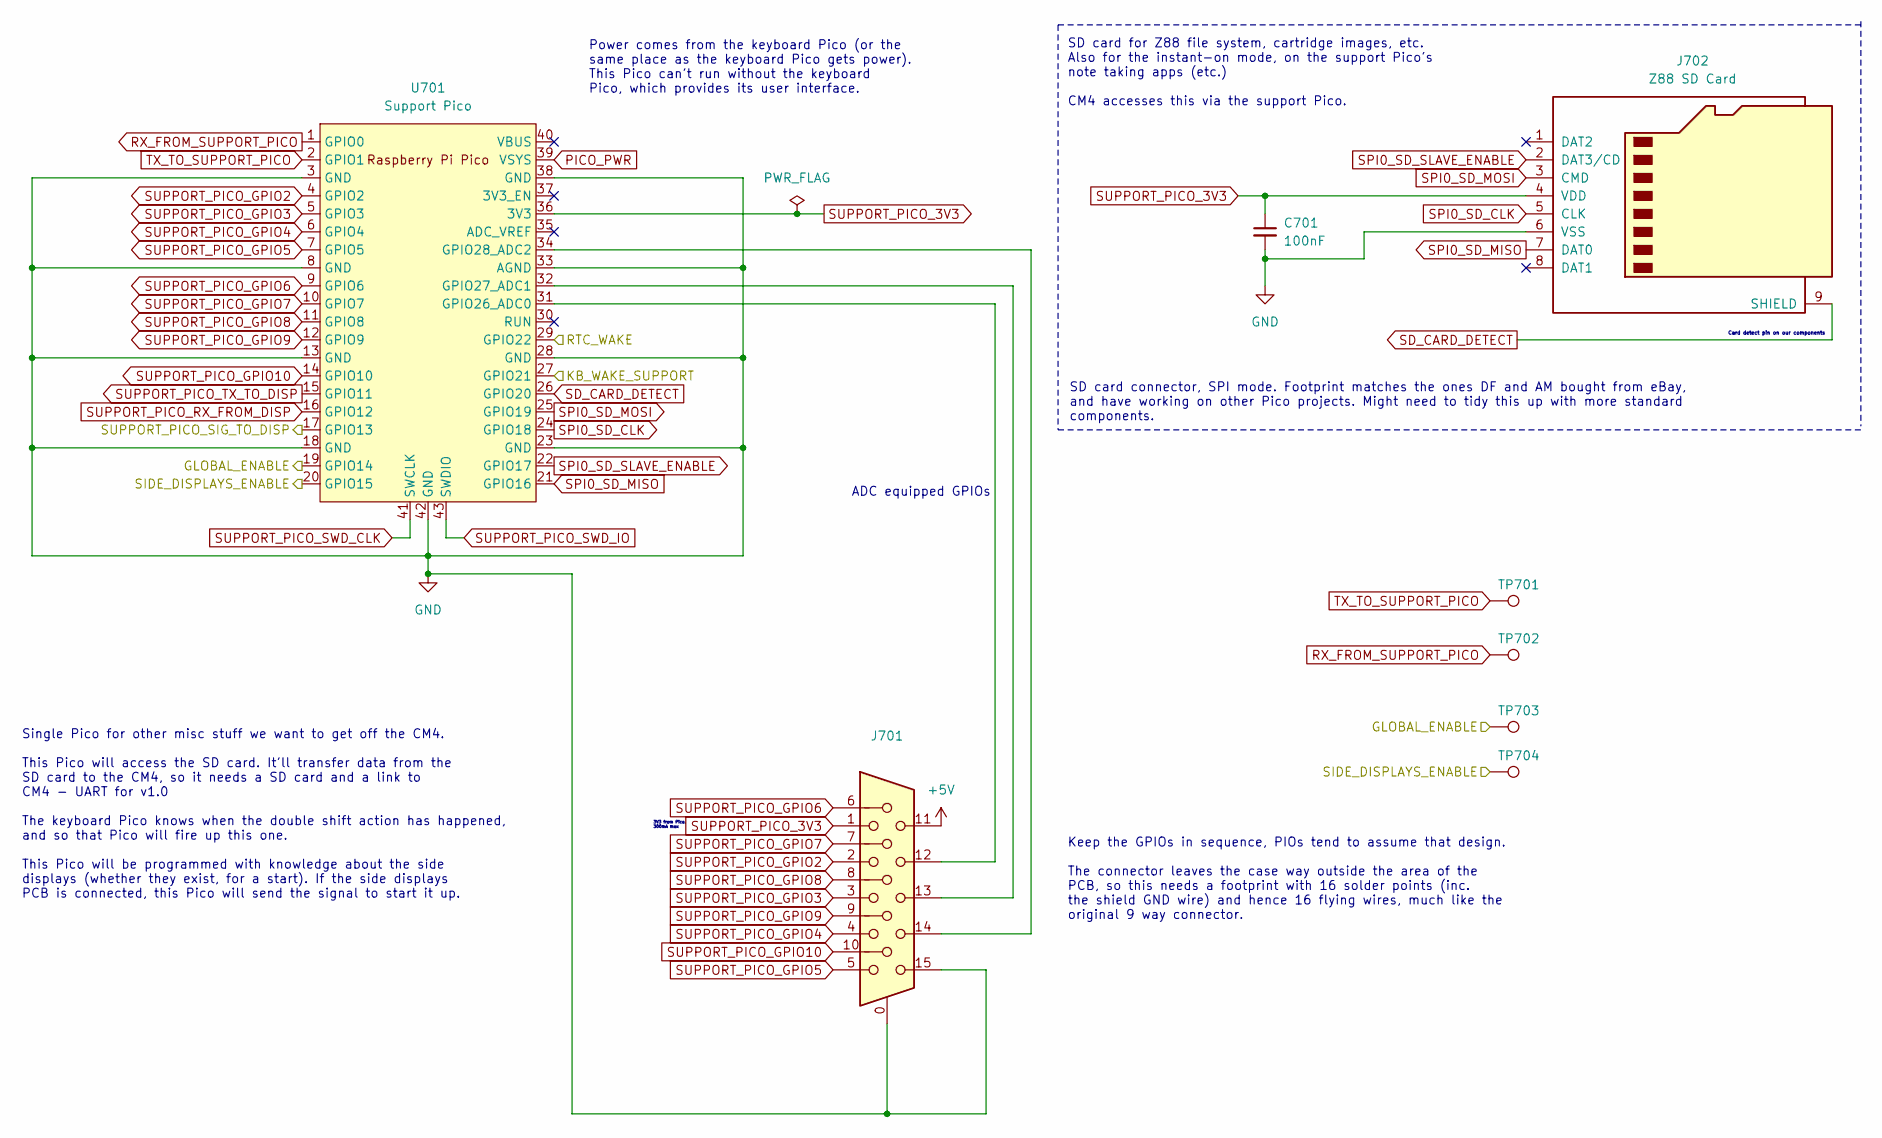
[picture p46: schematic support_pico.kicad_sch, Z88R - Z88 Recreated]

Parts:
C701: 100nF; C_0805_2012Metric_Pad1.18x1.45mm_HandSolder
J701: DE15_Receptacle_HighDensity_MountingHoles; DSUB-15-HD_Female_Vertical_P2.29x1.98mm_MountingHoles
J702: Z88 SD Card; Conn_uSDcard
TP701: TX to SP; TestPoint_THTPad_D2.0mm_Drill1.0mm
TP702: RX fr SP; TestPoint_THTPad_D2.0mm_Drill1.0mm
TP703: GL EN; TestPoint_THTPad_D2.0mm_Drill1.0mm
TP704: SIDE DISP EN; TestPoint_THTPad_D2.0mm_Drill1.0mm
U701: Support Pico; RPi_Pico_SMD_TH

Connections:
+5V: J701.11; also elsewhere on the board
/CM4_GPIO/GLOBAL_ENABLE: TP703.1, U701.19 (GPIO14); also elsewhere on the board
/Keyboard/KB_WAKE_SUPPORT: U701.27 (GPIO21); also elsewhere on the board
/Power/RTC_WAKE: U701.29 (GPIO22); also elsewhere on the board
/Side Displays/SIDE_DISPLAYS_ENABLE: TP704.1, U701.20 (GPIO15); also elsewhere on the board
/Side Displays/SUPPORT_PICO_SIG_TO_DISP: U701.17 (GPIO13); also elsewhere on the board
GND: C701.2, J701.0, J701.15, J702.6 (VSS), U701.3 (GND), U701.8 (GND), U701.13 (GND), U701.18 (GND), U701.23 (GND), U701.28 (GND), U701.33 (AGND), U701.38 (GND), U701.42 (GND); also elsewhere on the board
unnamed: J701.12, U701.31 (GPIO26_ADC0)
unnamed: J701.13, U701.32 (GPIO27_ADC1)
unnamed: J701.14, U701.34 (GPIO28_ADC2)
PICO_PWR: U701.39 (VSYS); also elsewhere on the board
RX_FROM_SUPPORT_PICO: TP702.1, U701.1 (GPIO0); also elsewhere on the board
SD_CARD_DETECT: J702.9 (SHIELD), U701.26 (GPIO20)
SPI0_SD_CLK: J702.5 (CLK), U701.24 (GPIO18)
SPI0_SD_MISO: J702.7 (DAT0), U701.21 (GPIO16)
SPI0_SD_MOSI: J702.3 (CMD), U701.25 (GPIO19)
SPI0_SD_SLAVE_ENABLE: J702.2 (DAT3/CD), U701.22 (GPIO17)
SUPPORT_PICO_3V3: C701.1, J701.1, J702.4 (VDD), U701.36 (3V3); also elsewhere on the board
SUPPORT_PICO_GPIO2: J701.2, U701.4 (GPIO2); also elsewhere on the board
SUPPORT_PICO_GPIO3: J701.3, U701.5 (GPIO3); also elsewhere on the board
SUPPORT_PICO_GPIO4: J701.4, U701.6 (GPIO4); also elsewhere on the board
SUPPORT_PICO_GPIO5: J701.5, U701.7 (GPIO5); also elsewhere on the board
SUPPORT_PICO_GPIO6: J701.6, U701.9 (GPIO6); also elsewhere on the board
SUPPORT_PICO_GPIO7: J701.7, U701.10 (GPIO7); also elsewhere on the board
SUPPORT_PICO_GPIO8: J701.8, U701.11 (GPIO8); also elsewhere on the board
SUPPORT_PICO_GPIO9: J701.9, U701.12 (GPIO9); also elsewhere on the board
SUPPORT_PICO_GPIO10: J701.10, U701.14 (GPIO10); also elsewhere on the board
SUPPORT_PICO_RX_FROM_DISP: U701.16 (GPIO12); also elsewhere on the board
SUPPORT_PICO_SWD_CLK: U701.41 (SWCLK); also elsewhere on the board
SUPPORT_PICO_SWD_IO: U701.43 (SWDIO); also elsewhere on the board
SUPPORT_PICO_TX_TO_DISP: U701.15 (GPIO11); also elsewhere on the board
TX_TO_SUPPORT_PICO: TP701.1, U701.2 (GPIO1); also elsewhere on the board

Notes on the sheet:
SD card for Z88 file system, cartridge images, etc. Also for the instant-on mode, on the support Pico's note taking apps (etc.) CM4 accesses this via the support Pico.
ADC equipped GPIOs
Power comes from the keyboard Pico (or the same place as the keyboard Pico gets power). This Pico can't run without the keyboard Pico, which provides its user interface.
Keep the GPIOs in sequence, PIOs tend to assume that design. The connector leaves the case way outside the area of the PCB, so this needs a footprint with 16 solder points (inc. the shield GND wire) and hence 16 flying wires, much like the original 9 way connector.
3V3 from Pico, 300mA max
Card detect pin on our components
Single Pico for other misc stuff we want to get off the CM4. This Pico will access the SD card. It'll transfer data from the SD card to the CM4, so it needs a SD card and a link to CM4 - UART for v1.0 The keyboard Pico knows when the double shift action has happened, and so that Pico will fire up t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
SD card connector, SPI mode. Footprint matches the ones DF and AM bought from eBay, and have working on other Pico projects. Might need to tidy this up with more standard components.

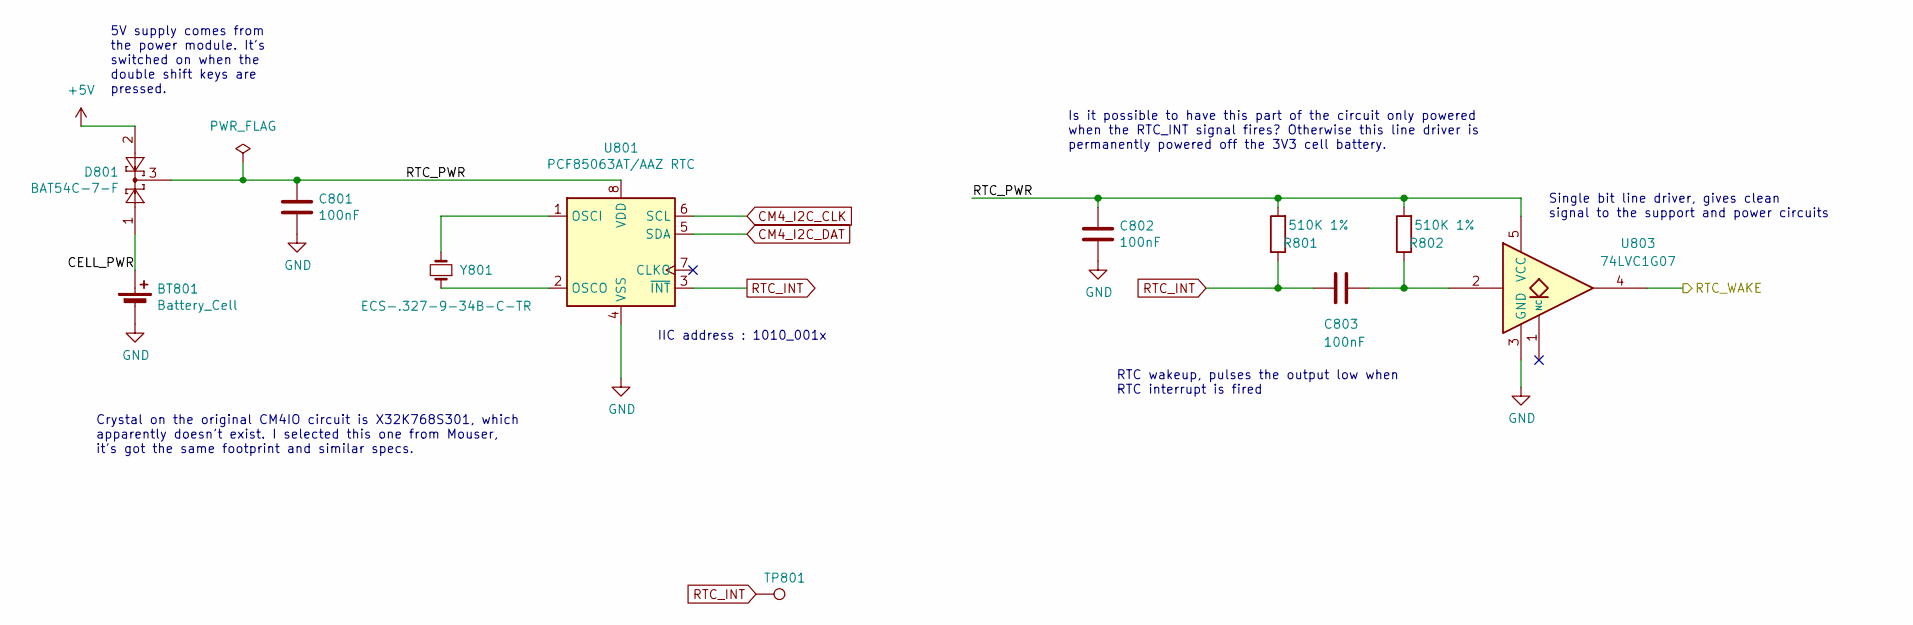
[picture p47: schematic rtc.kicad_sch, Z88R - Z88 Recreated]

Parts:
BT801: Battery_Cell; BatteryHolder_Keystone_3034_1x20mm; Part Description Battery Retainer Coin, 20.0mm 1 Cell SM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
C801, C802, C803: 100nF; C_0805_2012Metric_Pad1.18x1.45mm_HandSolder; Part Description 0.1uF 10% 16V Ceramic Capacitor X7R 040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
D801: BAT54C-7-F; SOT-23; Part Description Diode Array 1 Pair Common Cathode Schot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
R801, R802: 510K 1%; R_0805_2012Metric_Pad1.20x1.40mm_HandSolder; Part Description Resistor 510K M1005 1% 63mW
TP801: RTC INT; TestPoint_THTPad_D2.0mm_Drill1.0mm
U801: PCF85063AT/AAZ RTC; SOIC-8_3.9x4.9mm_P1.27mm; Part Description Real Time Clock (RTC) IC Clock/Calendar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
U803: 74LVC1G07; SOT-353_SC-70-5
Y801: ECS-.327-9-34B-C-TR; Crystal_SMD_3215-2Pin_3.2x1.5mm; Part Description Crystal 32.768KHz 7pF 20pmm

Connections:
+5V: D801.2; also elsewhere on the board
/Power/RTC_WAKE: U803.4; also elsewhere on the board
/RTC/CELL_PWR: BT801.1 (+), D801.1
/RTC/RTC_PWR: C801.1, C802.1, D801.3, R801.2, R802.2, U801.8 (VDD), U803.5 (VCC)
CM4_I2C_CLK: U801.6 (SCL); also elsewhere on the board
CM4_I2C_DAT: U801.5 (SDA); also elsewhere on the board
GND: BT801.2 (-), C801.2, C802.2, U801.4 (VSS), U803.3 (GND); also elsewhere on the board
unnamed: C803.1, R802.1, U803.2
unnamed: U801.1 (OSCI), Y801.2
unnamed: U801.2 (OSCO), Y801.1
RTC_INT: C803.2, R801.1, TP801.1, U801.3 (~INT)

Notes on the sheet:
RTC wakeup, pulses the output low when RTC interrupt is fired
5V supply comes from the power module. It's switched on when the double shift keys are pressed.
Single bit line driver, gives clean signal to the support and power circuits
Crystal on the original CM4IO circuit is X32K768S301, which apparently doesn't exist. I selected this one from Mouser, it's got the same footprint and similar specs.
Is it possible to have this part of the circuit only powered when the RTC_INT signal fires? Otherwise this line driver is permanently powered off the 3V3 cell battery.
IIC address : 1010_001x

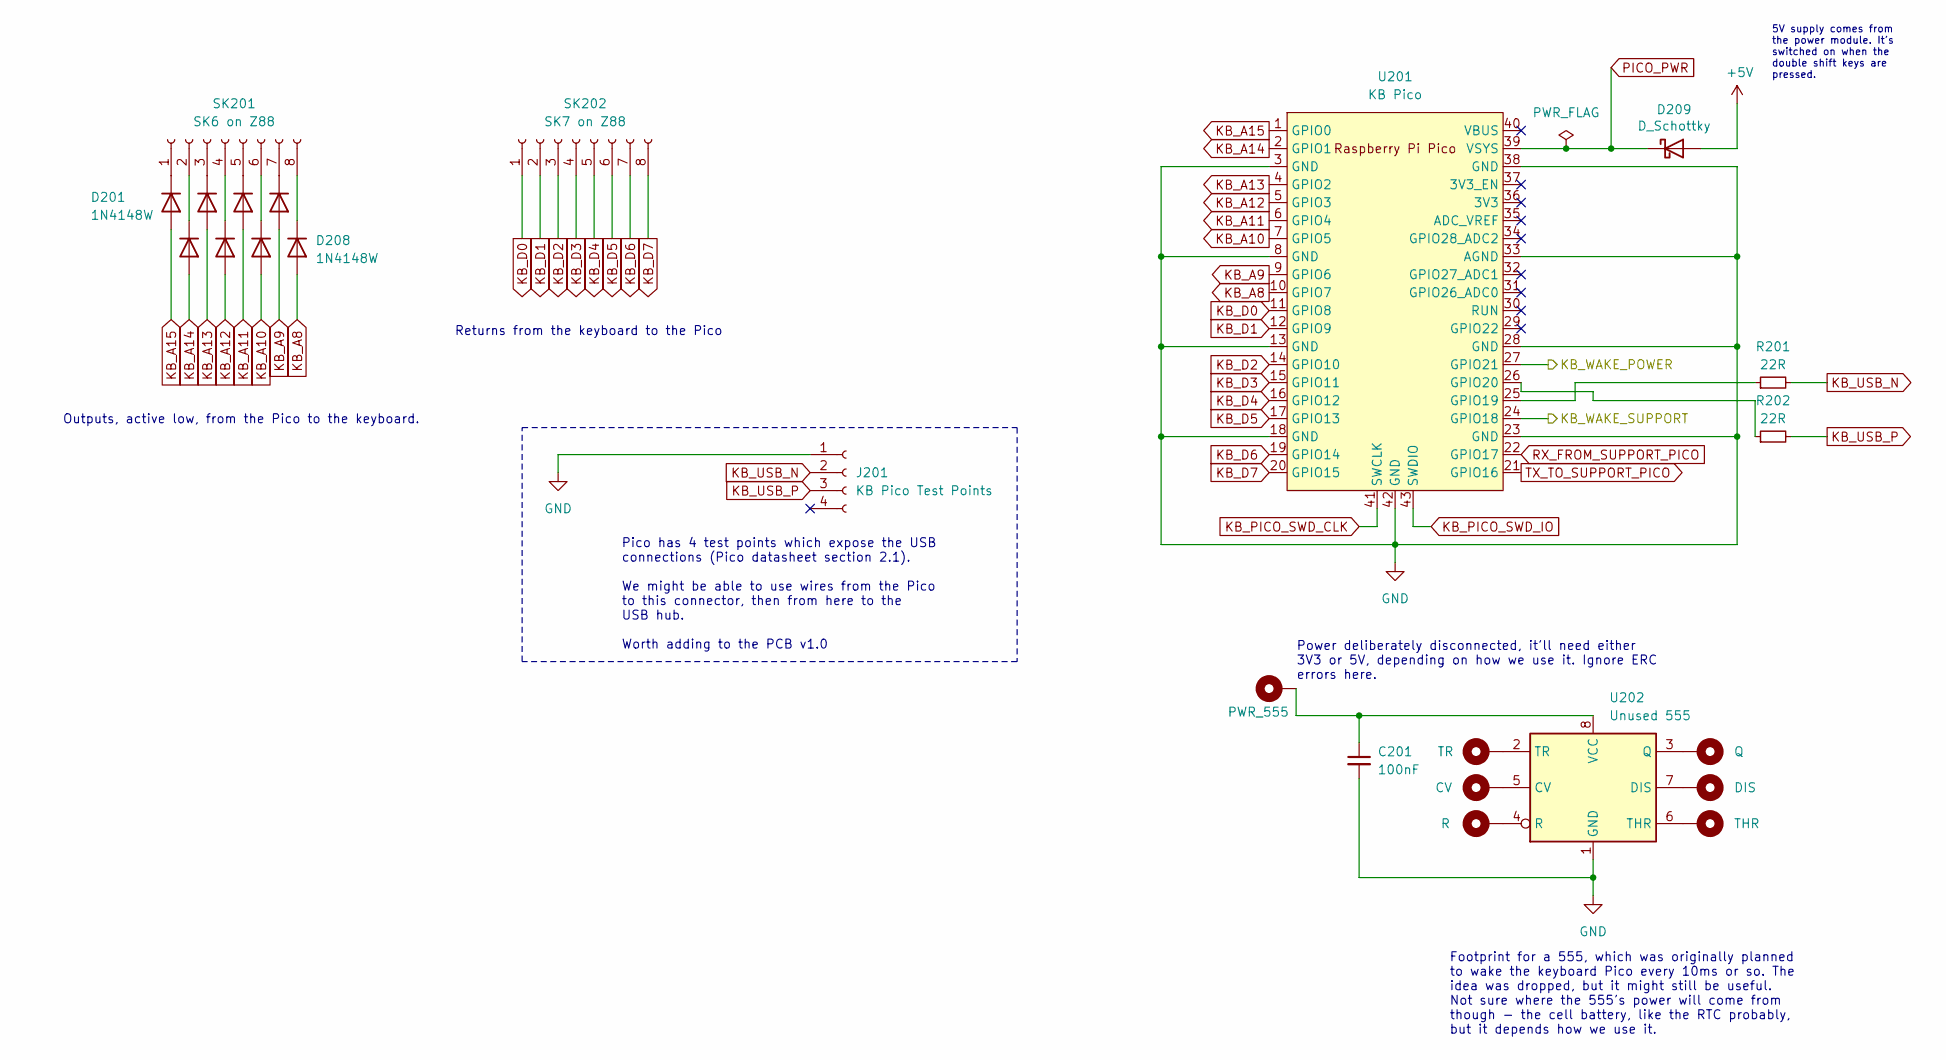
[picture p48: schematic keyboard.kicad_sch, Z88R - Z88 Recreated]

Parts:
C201: 100nF; C_0805_2012Metric_Pad1.18x1.45mm_HandSolder
D201, D202, D203, D204, D205, D206, D207, D208: 1N4148W; D_SOD-123
D209: D_Schottky; D_1206_3216Metric_Pad1.42x1.75mm_HandSolder
H201: TR; Pin_D0.7mm_L6.5mm_W1.8mm_FlatFork
H202: CV; Pin_D0.7mm_L6.5mm_W1.8mm_FlatFork
H203: R; Pin_D0.7mm_L6.5mm_W1.8mm_FlatFork
H204: Q; Pin_D0.7mm_L6.5mm_W1.8mm_FlatFork
H205: DIS; Pin_D0.7mm_L6.5mm_W1.8mm_FlatFork
H206: THR; Pin_D0.7mm_L6.5mm_W1.8mm_FlatFork
H207: PWR_555; Pin_D0.7mm_L6.5mm_W1.8mm_FlatFork
J201: KB Pico Test Points; PinHeader_1x04_P1.00mm_Vertical
R201, R202: 22R; R_0805_2012Metric_Pad1.20x1.40mm_HandSolder
SK201: SK6 on Z88; PinSocket_1x08_P2.54mm_Vertical
SK202: SK7 on Z88; PinSocket_1x08_P2.54mm_Vertical
U201: KB Pico; RPi_Pico_SMD_TH
U202: Unused 555; SOIC-8_3.9x4.9mm_P1.27mm

Connections:
+5V: D209.2 (A); also elsewhere on the board
/Keyboard/KB_WAKE_POWER: U201.27 (GPIO21); also elsewhere on the board
/Keyboard/KB_WAKE_SUPPORT: U201.24 (GPIO18); also elsewhere on the board
GND: C201.2, J201.1, U201.3 (GND), U201.8 (GND), U201.13 (GND), U201.18 (GND), U201.23 (GND), U201.28 (GND), U201.33 (AGND), U201.38 (GND), U201.42 (GND), U202.1 (GND); also elsewhere on the board
KB_A8: D208.2 (A), U201.10 (GPIO7)
KB_A9: D207.2 (A), U201.9 (GPIO6)
KB_A10: D206.2 (A), U201.7 (GPIO5)
KB_A11: D205.2 (A), U201.6 (GPIO4)
KB_A12: D204.2 (A), U201.5 (GPIO3)
KB_A13: D203.2 (A), U201.4 (GPIO2)
KB_A14: D202.2 (A), U201.2 (GPIO1)
KB_A15: D201.2 (A), U201.1 (GPIO0)
KB_D0: SK202.1, U201.11 (GPIO8)
KB_D1: SK202.2, U201.12 (GPIO9)
KB_D2: SK202.3, U201.14 (GPIO10)
KB_D3: SK202.4, U201.15 (GPIO11)
KB_D4: SK202.5, U201.16 (GPIO12)
KB_D5: SK202.6, U201.17 (GPIO13)
KB_D6: SK202.7, U201.19 (GPIO14)
KB_D7: SK202.8, U201.20 (GPIO15)
KB_PICO_SWD_CLK: U201.41 (SWCLK); also elsewhere on the board
KB_PICO_SWD_IO: U201.43 (SWDIO); also elsewhere on the board
KB_USB_N: J201.2, R201.2; also elsewhere on the board
KB_USB_P: J201.3, R202.2; also elsewhere on the board
unnamed: D201.1 (K), SK201.1
unnamed: D202.1 (K), SK201.2
unnamed: D203.1 (K), SK201.3
unnamed: D204.1 (K), SK201.4
unnamed: D205.1 (K), SK201.5
unnamed: D206.1 (K), SK201.6
unnamed: D207.1 (K), SK201.7
unnamed: D208.1 (K), SK201.8
unnamed: R201.1, U201.25 (GPIO19)
unnamed: R202.1, U201.26 (GPIO20)
unnamed: H202.1, U202.5 (CV)
unnamed: H205.1, U202.7 (DIS)
unnamed: H204.1, U202.3 (Q)
unnamed: H203.1, U202.4 (R)
unnamed: H206.1, U202.6 (THR)
unnamed: H201.1, U202.2 (TR)
unnamed: C201.1, H207.1, U202.8 (VCC)
PICO_PWR: D209.1 (K), U201.39 (VSYS); also elsewhere on the board
RX_FROM_SUPPORT_PICO: U201.22 (GPIO17); also elsewhere on the board
TX_TO_SUPPORT_PICO: U201.21 (GPIO16); also elsewhere on the board

Notes on the sheet:
Returns from the keyboard to the Pico
Pico has 4 test points which expose the USB connections (Pico datasheet section 2.1). We might be able to use wires from the Pico to this connector, then from here to the USB hub. Worth adding to the PCB v1.0
Power deliberately disconnected, it'll need either 3V3 or 5V, depending on how we use it. Ignore ERC errors here.
5V supply comes from the power module. It's switched on when the double shift keys are pressed.
Footprint for a 555, which was originally planned to wake the keyboard Pico every 10ms or so. The idea was dropped, but it might still be useful. Not sure where the 555's power will come from though - the cell battery, like the RTC probably, but it depends how we use it.
Outputs, active low, from the Pico to the keyboard.
