derekfountain/z88-recreation/hardware/pcb/main-board/z88_new.kicad_pcb

## KiCad design hardware/pcb/main-board/z88_new.kicad_pcb (continued)

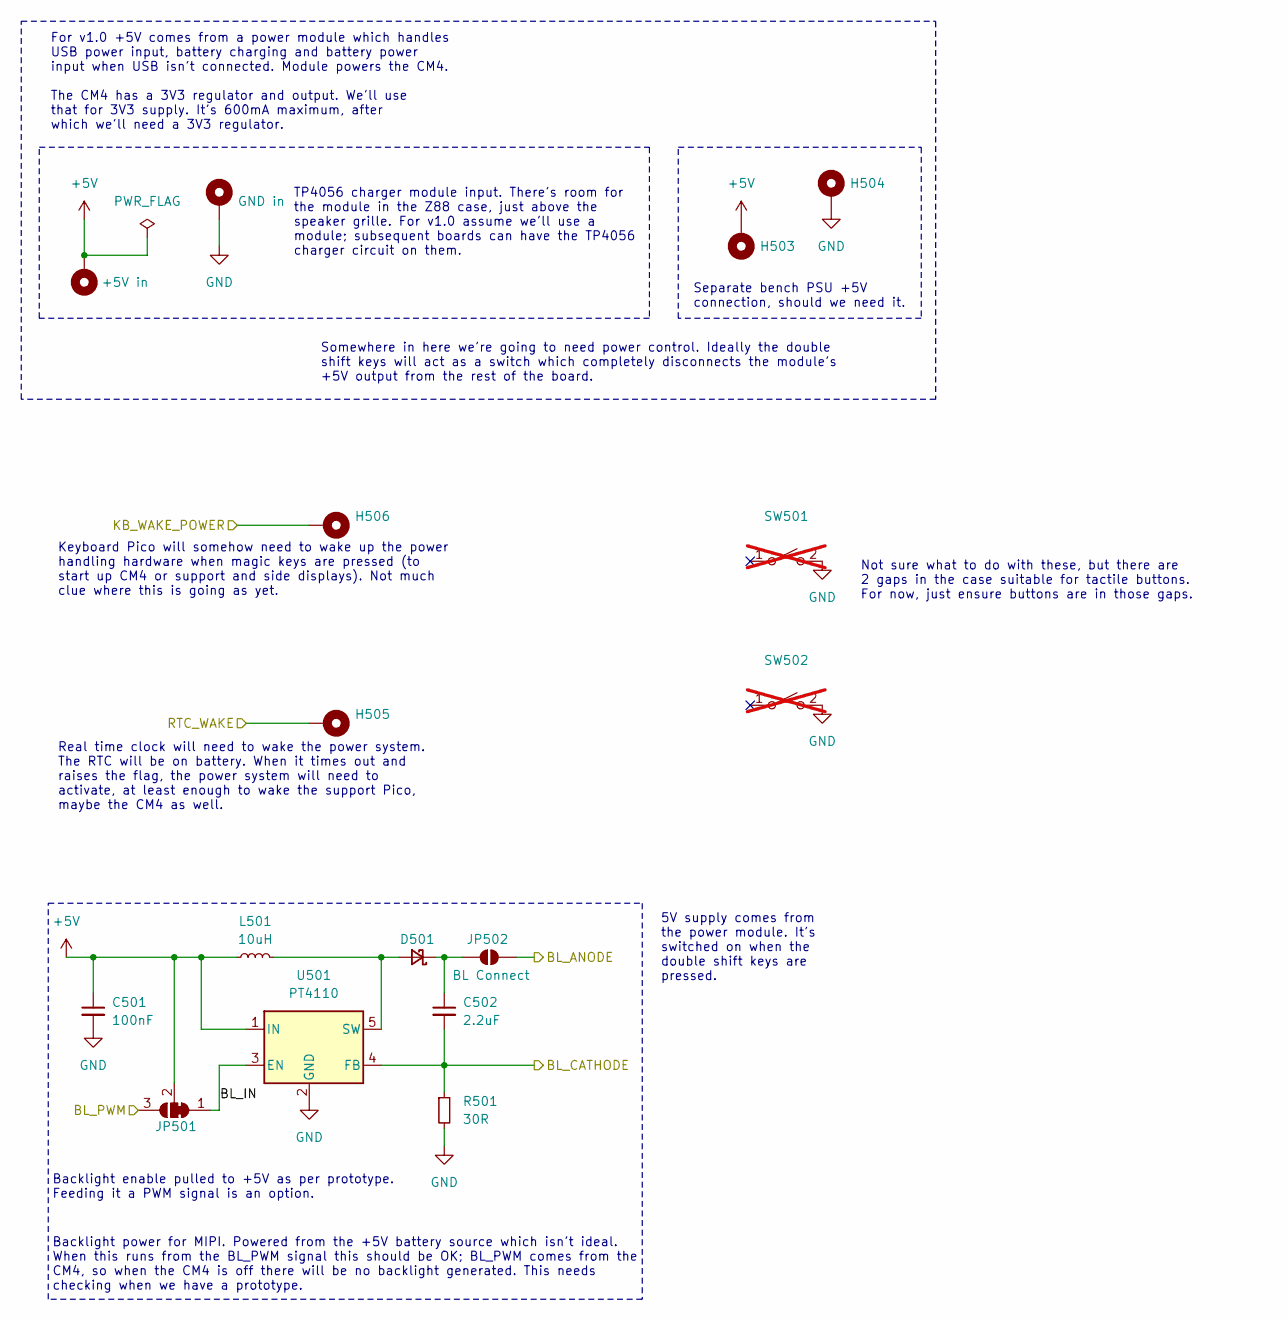
[picture p49: schematic power.kicad_sch, Z88R - Z88 Recreated]

Parts:
C501: 100nF; C_0805_2012Metric_Pad1.18x1.45mm_HandSolder
C502: 2.2uF; C_0805_2012Metric_Pad1.18x1.45mm_HandSolder
D501: D_Schottky_Small; D_1206_3216Metric_Pad1.42x1.75mm_HandSolder
H501: +5V in; MountingHole_2.2mm_M2_Pad
H502: GND in; MountingHole_2.2mm_M2_Pad
H503: +5V; MountingHole_2.2mm_M2_Pad
H504: GND; MountingHole_2.2mm_M2_Pad
H505: RTC Wake; TestPoint_THTPad_D2.0mm_Drill1.0mm
H506: KB Wake Power; TestPoint_THTPad_D2.0mm_Drill1.0mm
JP501: BL Source; SolderJumper-3_P1.3mm_Bridged2Bar12_Pad1.0x1.5mm
JP502: BL Connect; SolderJumper-2_P1.3mm_Open_Pad1.0x1.5mm
L501: 10uH; L_Coilcraft_XAL7070-XXX
R501: 30R; R_0805_2012Metric_Pad1.20x1.40mm_HandSolder
SW501, SW502: NO POP; SW_Tactile_SKHH_Angled; not fitted
U501: PT4110; SOT-89-5_Handsoldering

Connections:
+5V: C501.1, H501.1, H503.1, JP501.2 (C), L501.1, U501.1 (IN); also elsewhere on the board
/CM4_GPIO/BL_PWM: JP501.3 (B); also elsewhere on the board
/CM4_HighSpeed/BL_ANODE: JP502.2 (B); also elsewhere on the board
/CM4_HighSpeed/BL_CATHODE: C502.2, R501.1, U501.4 (FB); also elsewhere on the board
/Keyboard/KB_WAKE_POWER: H506.1; also elsewhere on the board
/Power/BL_IN: JP501.1 (A), U501.3 (EN)
/Power/RTC_WAKE: H505.1; also elsewhere on the board
GND: C501.2, H502.1, H504.1, R501.2, SW501.2 (B), SW502.2 (B), U501.2 (GND); also elsewhere on the board
unnamed: D501.2 (A), L501.2, U501.5 (SW)
unnamed: C502.1, D501.1 (K), JP502.1 (A)

Notes on the sheet:
Somewhere in here we're going to need power control. Ideally the double shift keys will act as a switch which completely disconnects the module's +5V output from the rest of the board.
For v1.0 +5V comes from a power module which handles USB power input, battery charging and battery power input when USB isn't connected. Module powers the CM4. The CM4 has a 3V3 regulator and output. We'll use that for 3V3 supply. It's 600mA maximum, after which we'll need a 3V3 regulator.
TP4056 charger module input. There's room for the module in the Z88 case, just above the speaker grille. For v1.0 assume we'll use a module; subsequent boards can have the TP4056 charger circuit on them.
Backlight power for MIPI. Powered from the +5V battery source which isn't ideal. When this runs from the BL_PWM signal this should be OK; BL_PWM comes from the CM4, so when the CM4 is off there will be no backlight generated. This needs checking when we have a prototype.
Real time clock will need to wake the power system. The RTC will be on battery. When it times out and raises the flag, the power system will need to activate, at least enough to wake the support Pico, maybe the CM4 as well.
Keyboard Pico will somehow need to wake up the power handling hardware when magic keys are pressed (to start up CM4 or support and side displays). Not much clue where this is going as yet.
Separate bench PSU +5V connection, should we need it.
Backlight enable pulled to +5V as per prototype. Feeding it a PWM signal is an option.
Not sure what to do with these, but there are 2 gaps in the case suitable for tactile buttons. For now, just ensure buttons are in those gaps.
5V supply comes from the power module. It's switched on when the double shift keys are pressed.

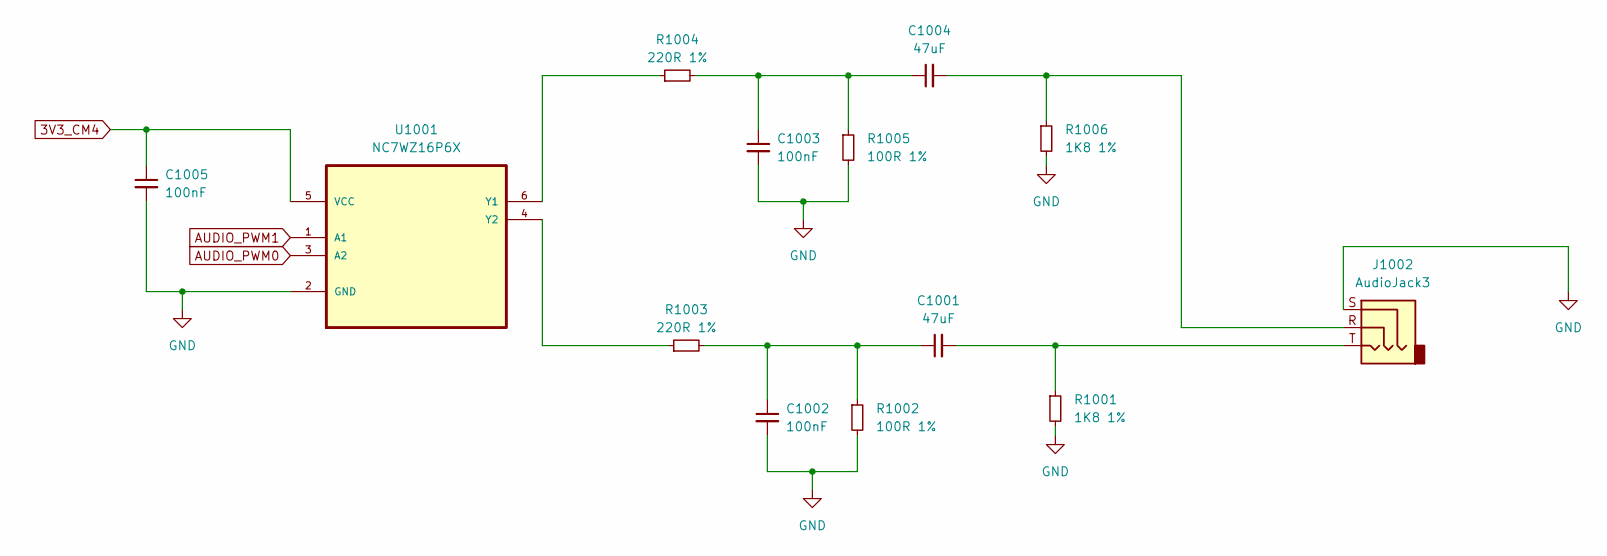
[picture p50: schematic audio.kicad_sch, Z88R - Z88 Recreated]

Parts:
C1001, C1004: 47uF; C_0805_2012Metric_Pad1.18x1.45mm_HandSolder
C1002, C1003, C1005: 100nF; C_0805_2012Metric_Pad1.18x1.45mm_HandSolder
J1002: AudioJack3; Jack_3.5mm_CUI_SJ1-3533NG_Horizontal
R1001, R1006: 1K8 1%; R_0805_2012Metric_Pad1.20x1.40mm_HandSolder
R1002, R1005: 100R 1%; R_0805_2012Metric_Pad1.20x1.40mm_HandSolder
R1003, R1004: 220R 1%; R_0805_2012Metric_Pad1.20x1.40mm_HandSolder
U1001: NC7WZ16P6X; SOT-363_SC-70-6_Handsoldering; MPN NC7WZ16P6X

Connections:
3V3_CM4: C1005.1, U1001.5 (VCC); also elsewhere on the board
AUDIO_PWM0: U1001.3 (A2); also elsewhere on the board
AUDIO_PWM1: U1001.1 (A1); also elsewhere on the board
GND: C1002.2, C1003.2, C1005.2, J1002.S, R1001.2, R1002.2, R1005.2, R1006.2, U1001.2 (GND); also elsewhere on the board
unnamed: C1001.1, C1002.1, R1002.1, R1003.2
unnamed: C1001.2, J1002.T, R1001.1
unnamed: C1003.1, C1004.1, R1004.2, R1005.1
unnamed: C1004.2, J1002.R, R1006.1
unnamed: R1004.1, U1001.6 (Y1)
unnamed: R1003.1, U1001.4 (Y2)

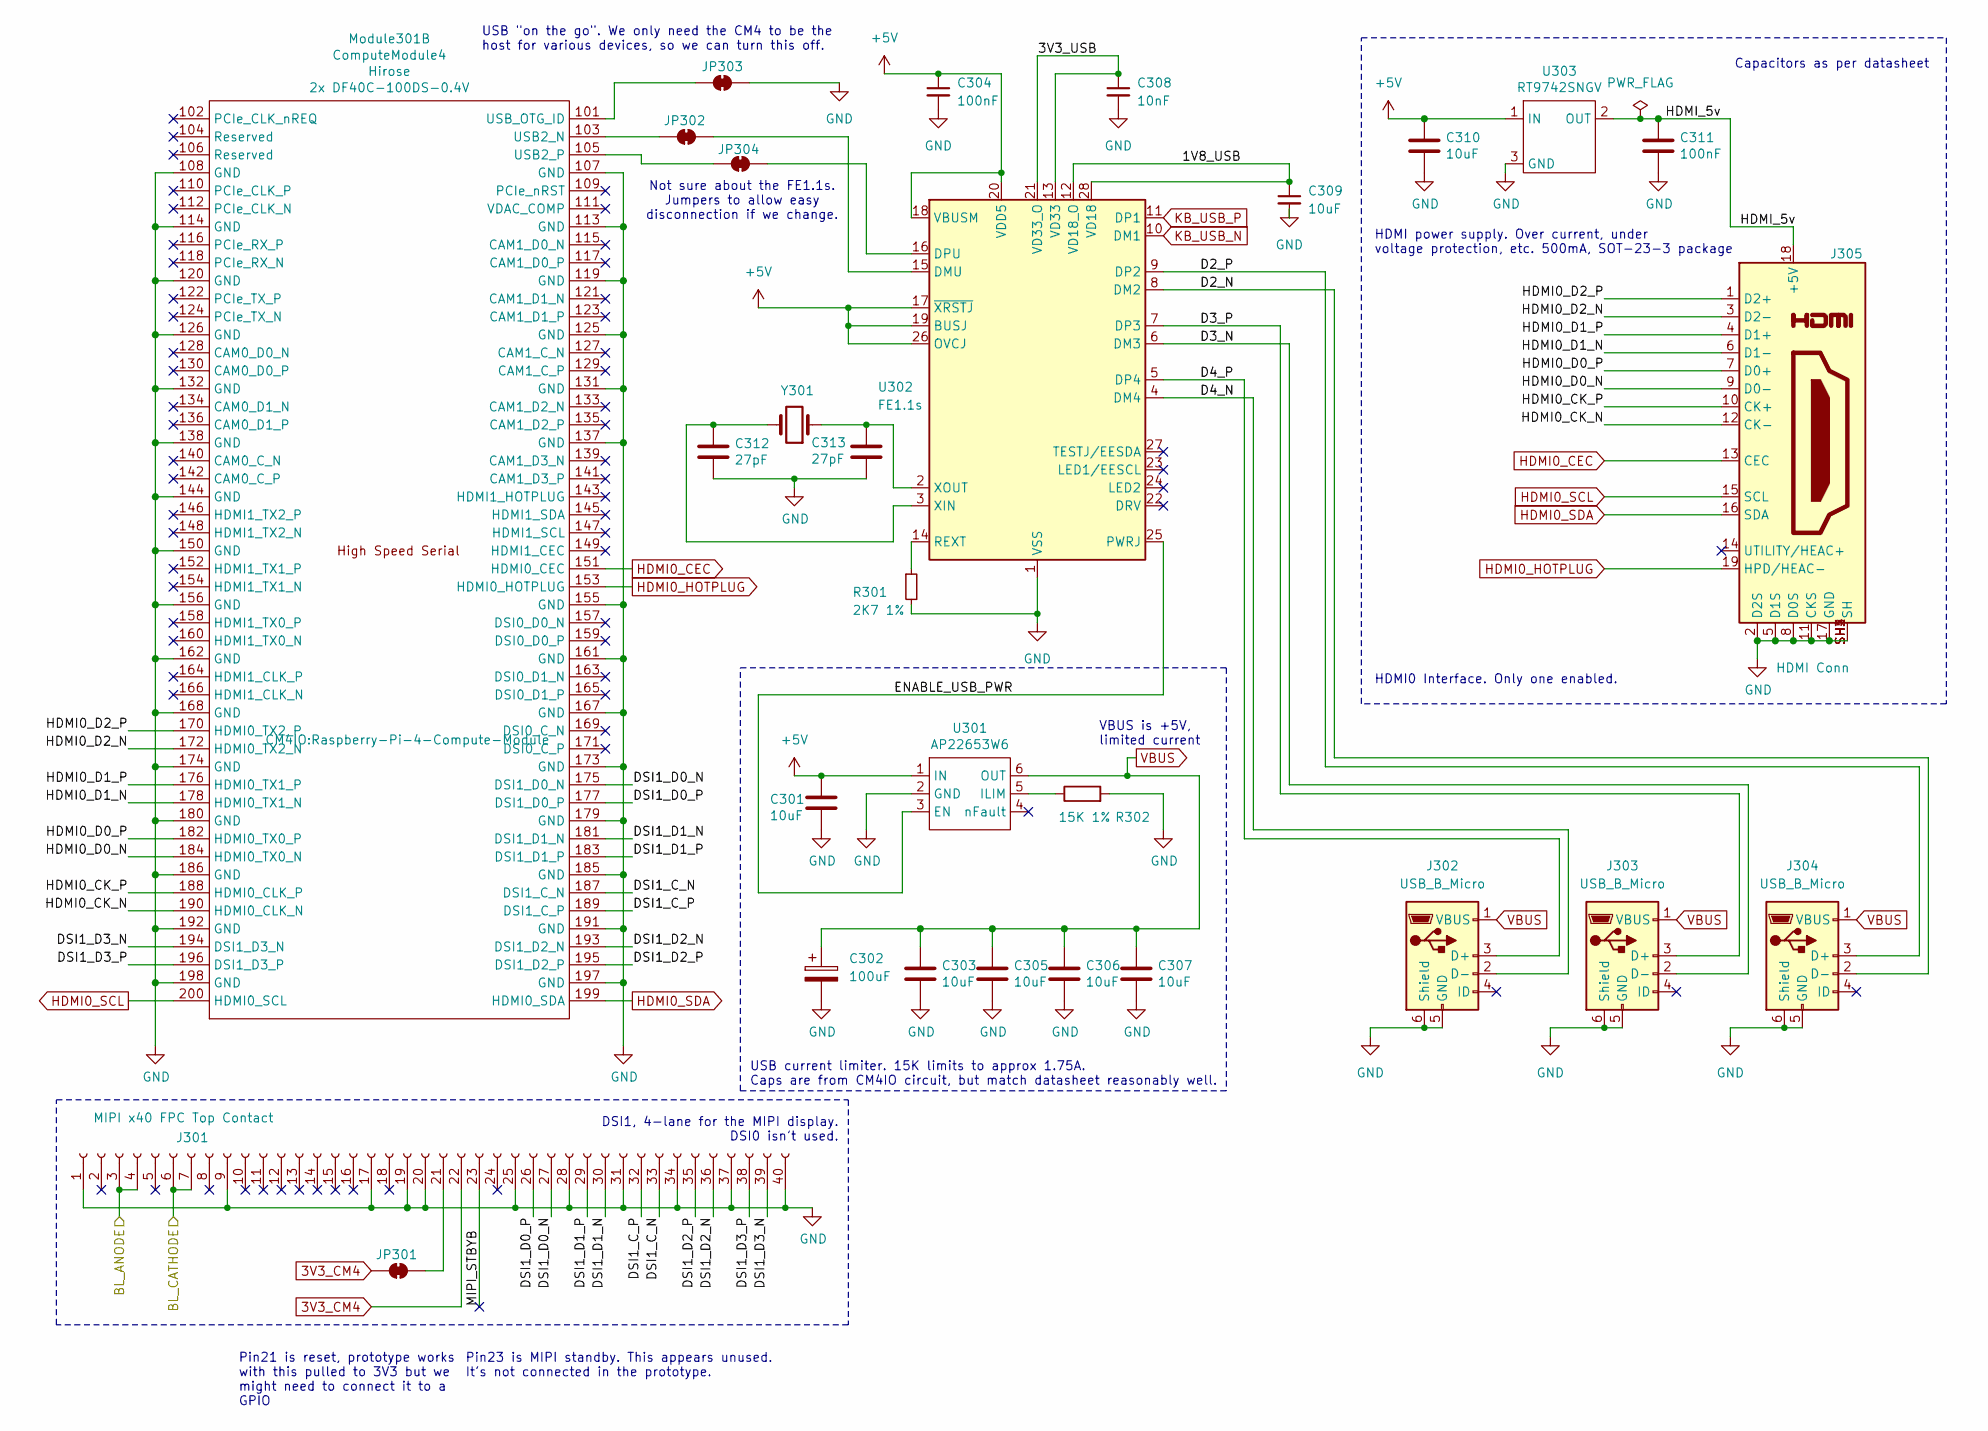
[picture p51: schematic cm4_highspeed.kicad_sch, Z88R - Z88 Recreated]

Parts:
C301, C303, C305, C306, C307: 10uF; C_0805_2012Metric_Pad1.18x1.45mm_HandSolder; Part Description 10uF 10% 10V Ceramic Capacitor X7R 0805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
C302: 100uF; C_0805_2012Metric_Pad1.18x1.45mm_HandSolder
C304: 100nF; C_0805_2012Metric_Pad1.18x1.45mm_HandSolder
C308: 10nF; C_0805_2012Metric_Pad1.18x1.45mm_HandSolder
C309: 10uF; C_0805_2012Metric_Pad1.18x1.45mm_HandSolder
C310: 10uF; C_0805_2012Metric_Pad1.18x1.45mm_HandSolder; Part Description 0.1uF 10% 16V Ceramic Capacitor X7R 040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
C311: 100nF; C_0805_2012Metric_Pad1.18x1.45mm_HandSolder; Part Description 0.1uF 10% 16V Ceramic Capacitor X7R 040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
C312, C313: 27pF; C_0805_2012Metric_Pad1.18x1.45mm_HandSolder; Part Description 27pF 5% 50V Ceramic Capacitor C0G, NP0 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
J301: MIPI x40 FPC Top Contact; Hirose_FH12-40S-0.5SH_1x40-1MP_P0.50mm_Horizontal
J302, J303, J304: USB_B_Micro; USB_Micro-B_Amphenol_10103594-0001LF_Horizontal
J305: HDMI Conn; EDAC 690-019-298-412; Part Description HDMI Connector, Right Angle, 19 Contact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
JP301: MIPI Reset; SolderJumper-2_P1.3mm_Bridged_Pad1.0x1.5mm
JP302, JP303, JP304: SolderJumper_2_Bridged; SolderJumper-2_P1.3mm_Bridged_Pad1.0x1.5mm
Module301: ComputeModule4; Raspberry-Pi-4-Compute-Module; Part Description 100 Position Connector Receptacle, Cent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
R301: 2K7 1%; R_0805_2012Metric_Pad1.20x1.40mm_HandSolder
R302: 15K 1%; R_0805_2012Metric_Pad1.20x1.40mm_HandSolder; Part Description Resistor 15K M1005 1% 63mW
U301: AP22653W6; SOT-23-6; Part Description Power Switch/Driver 1:1 P-Channel 2.1A 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
U302: FE1.1s; SSOP-28_3.9x9.9mm_P0.635mm
U303: RT9742SNGV; SOT-23; Part Description Power Switch/Driver 1:1 N-Channel 500mA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
Y301: ABLS-12.000MHZ-B4-T; Crystal_SMD_HC49-SD

Connections:
3V3_CM4: J301.22, JP301.1 (A); also elsewhere on the board
+5V: C301.1, C304.1, C310.1, U301.1 (IN), U302.17 (~XRSTJ), U302.18 (VBUSM), U302.19 (BUSJ), U302.20 (VDD5), U302.26 (OVCJ), U303.1 (IN); also elsewhere on the board
/CM4_HighSpeed/1V8_USB: C309.1, U302.12 (VD18_O), U302.28 (VD18)
/CM4_HighSpeed/3V3_USB: C308.1, U302.13 (VD33), U302.21 (VD33_O)
/CM4_HighSpeed/BL_ANODE: J301.3, J301.4; also elsewhere on the board
/CM4_HighSpeed/BL_CATHODE: J301.6, J301.7; also elsewhere on the board
/CM4_HighSpeed/D2_N: J304.2 (D-), U302.8 (DM2)
/CM4_HighSpeed/D2_P: J304.3 (D+), U302.9 (DP2)
/CM4_HighSpeed/D3_N: J303.2 (D-), U302.6 (DM3)
/CM4_HighSpeed/D3_P: J303.3 (D+), U302.7 (DP3)
/CM4_HighSpeed/D4_N: J302.2 (D-), U302.4 (DM4)
/CM4_HighSpeed/D4_P: J302.3 (D+), U302.5 (DP4)
/CM4_HighSpeed/DSI1_C_N: J301.33, Module301.187 (DSI1_C_N)
/CM4_HighSpeed/DSI1_C_P: J301.32, Module301.189 (DSI1_C_P)
/CM4_HighSpeed/DSI1_D0_N: J301.27, Module301.175 (DSI1_D0_N)
/CM4_HighSpeed/DSI1_D0_P: J301.26, Module301.177 (DSI1_D0_P)
/CM4_HighSpeed/DSI1_D1_N: J301.30, Module301.181 (DSI1_D1_N)
/CM4_HighSpeed/DSI1_D1_P: J301.29, Module301.183 (DSI1_D1_P)
/CM4_HighSpeed/DSI1_D2_N: J301.36, Module301.193 (DSI1_D2_N)
/CM4_HighSpeed/DSI1_D2_P: J301.35, Module301.195 (DSI1_D2_P)
/CM4_HighSpeed/DSI1_D3_N: J301.39, Module301.194 (DSI1_D3_N)
/CM4_HighSpeed/DSI1_D3_P: J301.38, Module301.196 (DSI1_D3_P)
/CM4_HighSpeed/ENABLE_USB_PWR: U301.3 (EN), U302.25 (PWRJ)
/CM4_HighSpeed/HDMI0_CK_N: J305.12 (CK-), Module301.190 (HDMI0_CLK_N)
/CM4_HighSpeed/HDMI0_CK_P: J305.10 (CK+), Module301.188 (HDMI0_CLK_P)
/CM4_HighSpeed/HDMI0_D0_N: J305.9 (D0-), Module301.184 (HDMI0_TX0_N)
/CM4_HighSpeed/HDMI0_D0_P: J305.7 (D0+), Module301.182 (HDMI0_TX0_P)
/CM4_HighSpeed/HDMI0_D1_N: J305.6 (D1-), Module301.178 (HDMI0_TX1_N)
/CM4_HighSpeed/HDMI0_D1_P: J305.4 (D1+), Module301.176 (HDMI0_TX1_P)
/CM4_HighSpeed/HDMI0_D2_N: J305.3 (D2-), Module301.172 (HDMI0_TX2_N)
/CM4_HighSpeed/HDMI0_D2_P: J305.1 (D2+), Module301.170 (HDMI0_TX2_P)
/CM4_HighSpeed/HDMI_5v: C311.1, J305.18 (+5V), U303.2 (OUT)
/CM4_HighSpeed/MIPI_STBYB: J301.23
GND: C301.2, C302.2, C303.2, C304.2, C305.2, C306.2, C307.2, C308.2, C309.2, C310.2, C311.2, C312.2, C313.2, J301.1, J301.9, J301.17, J301.19, J301.20, J301.25, J301.28, J301.31, J301.34, J301.37, J301.40, J302.5 (GND), J302.6 (Shield), J303.5 (GND), J303.6 (Shield), J304.5 (GND), J304.6 (Shield), J305.2 (D2S), J305.5 (D1S), J305.8 (D0S), J305.11 (CKS), J305.17 (GND), J305.SH1 (SH), J305.SH2 (SH), J305.SH3 (SH), J305.SH4 (SH), JP303.2 (B), Module301.107 (GND), Module301.108 (GND), Module301.113 (GND), Module301.114 (GND), Module301.119 (GND), Module301.120 (GND), Module301.125 (GND), Module301.126 (GND), Module301.131 (GND), Module301.132 (GND), Module301.137 (GND), Module301.138 (GND), Module301.144 (GND), Module301.150 (GND), Module301.155 (GND), Module301.156 (GND), Module301.161 (GND), Module301.162 (GND), Module301.167 (GND), Module301.168 (GND), Module301.173 (GND), Module301.174 (GND), Module301.179 (GND), Module301.180 (GND), Module301.185 (GND), Module301.186 (GND), Module301.191 (GND), Module301.192 (GND), Module301.197 (GND), Module301.198 (GND), R301.2, R302.2, U301.2 (GND), U302.1 (VSS), U303.3 (GND); also elsewhere on the board
HDMI0_CEC: J305.13 (CEC), Module301.151 (HDMI0_CEC)
HDMI0_HOTPLUG: J305.19 (HPD/HEAC-), Module301.153 (HDMI0_HOTPLUG)
HDMI0_SCL: J305.15 (SCL), Module301.200 (HDMI0_SCL)
HDMI0_SDA: J305.16 (SDA), Module301.199 (HDMI0_SDA)
KB_USB_N: U302.10 (DM1); also elsewhere on the board
KB_USB_P: U302.11 (DP1); also elsewhere on the board
unnamed: J301.21, JP301.2 (B)
unnamed: JP302.1 (A), Module301.103 (USB2_N)
unnamed: JP302.2 (B), U302.15 (DMU)
unnamed: JP303.1 (A), Module301.101 (USB_OTG_ID)
unnamed: JP304.1 (A), Module301.105 (USB2_P)
unnamed: JP304.2 (B), U302.16 (DPU)
unnamed: R302.1, U301.5 (ILIM)
unnamed: R301.1, U302.14 (REXT)
unnamed: C312.1, U302.3 (XIN), Y301.2
unnamed: C313.1, U302.2 (XOUT), Y301.1
VBUS: C302.1, C303.1, C305.1, C306.1, C307.1, J302.1 (VBUS), J303.1 (VBUS), J304.1 (VBUS), U301.6 (OUT)

Notes on the sheet:
DSI1, 4-lane for the MIPI display. DSI0 isn't used.
Pin23 is MIPI standby. This appears unused. It's not connected in the prototype.
USB "on the go". We only need the CM4 to be the host for various devices, so we can turn this off.
VBUS is +5V, limited current
Not sure about the FE1.1s. Jumpers to allow easy disconnection if we change.
Pin21 is reset, prototype works with this pulled to 3V3 but we might need to connect it to a GPIO
USB current limiter. 15K limits to approx 1.75A. Caps are from CM4IO circuit, but match datasheet reasonably well.
Capacitors as per datasheet
HDMI power supply. Over current, under voltage protection, etc. 500mA, SOT-23-3 package
HDMI0 Interface. Only one enabled.

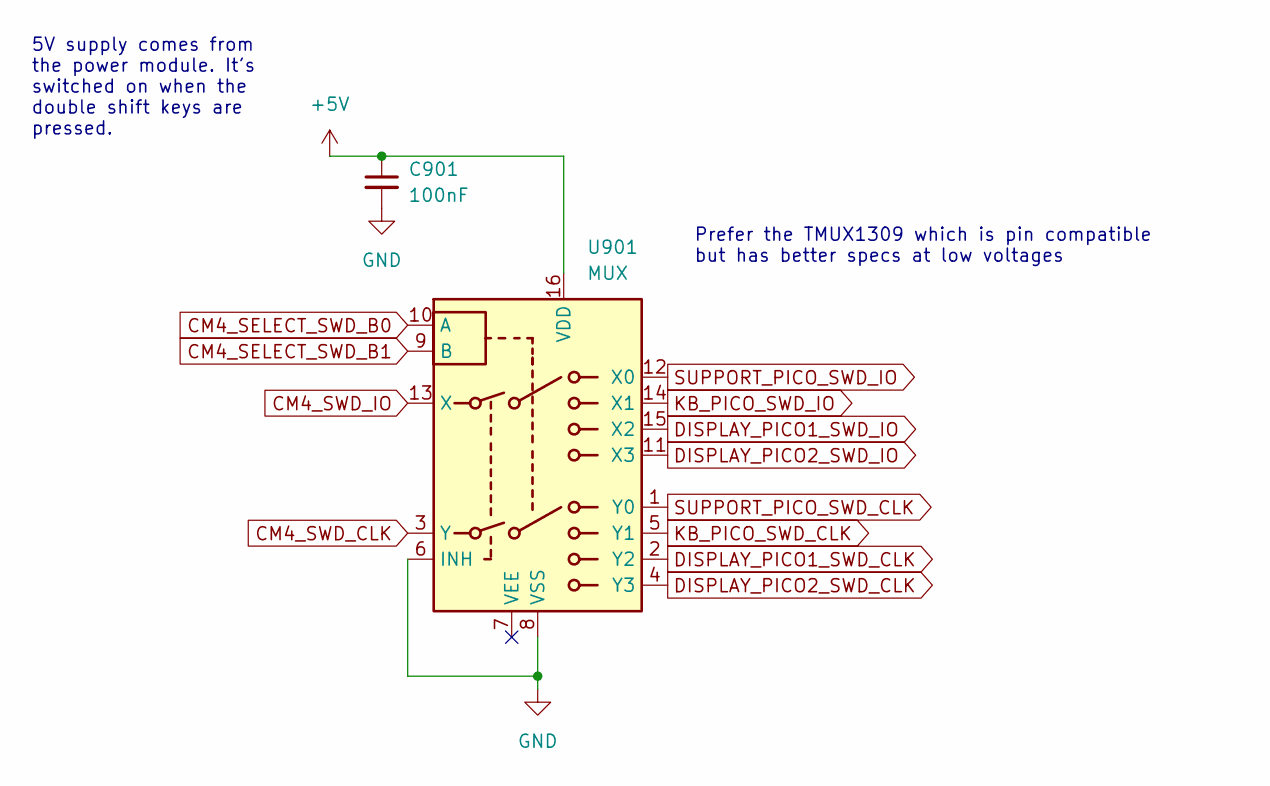
[picture p52: schematic swdmux.kicad_sch, Z88R - Z88 Recreated]

Parts:
C901: 100nF; C_0805_2012Metric_Pad1.18x1.45mm_HandSolder
U901: MUX; Texas_DYY0016A_TSOT-23-16_4.2x2.0mm_P0.5mm

Connections:
+5V: C901.1, U901.16 (VDD); also elsewhere on the board
CM4_SELECT_SWD_B0: U901.10 (A); also elsewhere on the board
CM4_SELECT_SWD_B1: U901.9 (B); also elsewhere on the board
CM4_SWD_CLK: U901.3 (Y); also elsewhere on the board
CM4_SWD_IO: U901.13 (X); also elsewhere on the board
DISPLAY_PICO1_SWD_CLK: U901.2 (Y2); also elsewhere on the board
DISPLAY_PICO1_SWD_IO: U901.15 (X2); also elsewhere on the board
DISPLAY_PICO2_SWD_CLK: U901.4 (Y3); also elsewhere on the board
DISPLAY_PICO2_SWD_IO: U901.11 (X3); also elsewhere on the board
GND: C901.2, U901.6 (INH), U901.8 (VSS); also elsewhere on the board
KB_PICO_SWD_CLK: U901.5 (Y1); also elsewhere on the board
KB_PICO_SWD_IO: U901.14 (X1); also elsewhere on the board
SUPPORT_PICO_SWD_CLK: U901.1 (Y0); also elsewhere on the board
SUPPORT_PICO_SWD_IO: U901.12 (X0); also elsewhere on the board

Notes on the sheet:
Prefer the TMUX1309 which is pin compatible but has better specs at low voltages
5V supply comes from the power module. It's switched on when the double shift keys are pressed.

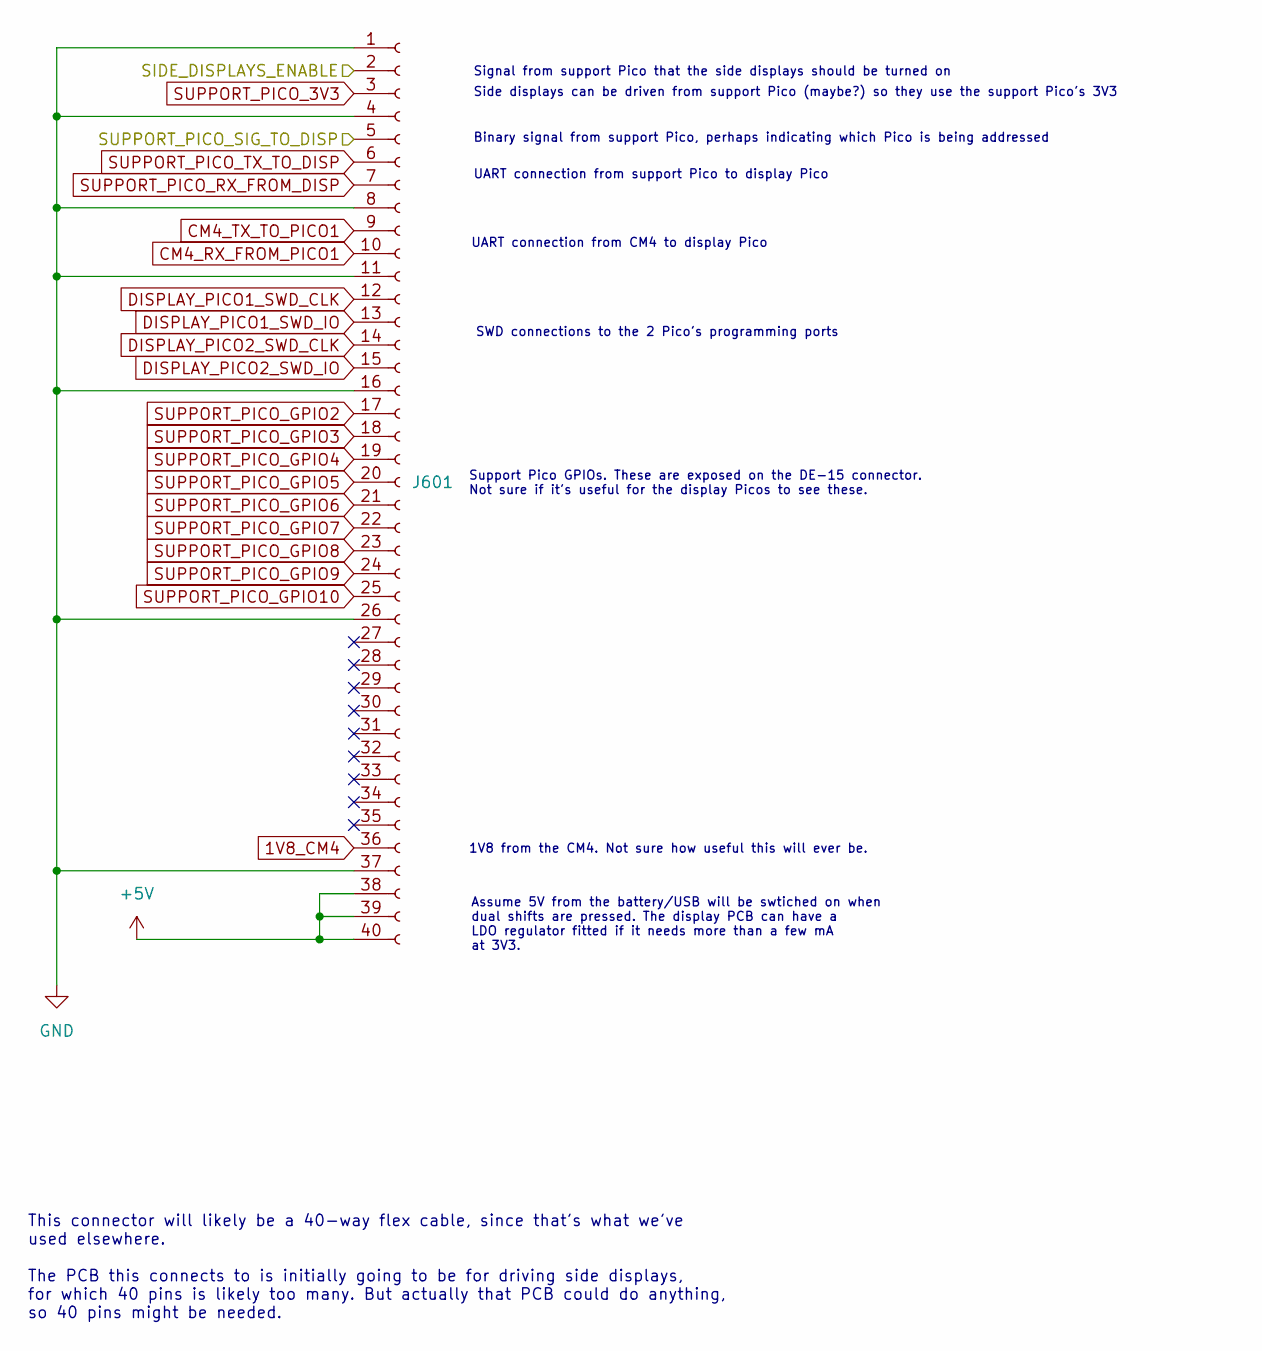
[picture p53: schematic displays.kicad_sch, Z88R - Z88 Recreated]

Parts:
J601: DISP_PCB x40 FPC; Hirose_FH12-40S-0.5SH_1x40-1MP_P0.50mm_Horizontal

Connections:
1V8_CM4: J601.36; also elsewhere on the board
+5V: J601.38, J601.39, J601.40; also elsewhere on the board
/Side Displays/SIDE_DISPLAYS_ENABLE: J601.2; also elsewhere on the board
/Side Displays/SUPPORT_PICO_SIG_TO_DISP: J601.5; also elsewhere on the board
CM4_RX_FROM_PICO1: J601.10; also elsewhere on the board
CM4_TX_TO_PICO1: J601.9; also elsewhere on the board
DISPLAY_PICO1_SWD_CLK: J601.12; also elsewhere on the board
DISPLAY_PICO1_SWD_IO: J601.13; also elsewhere on the board
DISPLAY_PICO2_SWD_CLK: J601.14; also elsewhere on the board
DISPLAY_PICO2_SWD_IO: J601.15; also elsewhere on the board
GND: J601.1, J601.4, J601.8, J601.11, J601.16, J601.26, J601.37; also elsewhere on the board
SUPPORT_PICO_3V3: J601.3; also elsewhere on the board
SUPPORT_PICO_GPIO2: J601.17; also elsewhere on the board
SUPPORT_PICO_GPIO3: J601.18; also elsewhere on the board
SUPPORT_PICO_GPIO4: J601.19; also elsewhere on the board
SUPPORT_PICO_GPIO5: J601.20; also elsewhere on the board
SUPPORT_PICO_GPIO6: J601.21; also elsewhere on the board
SUPPORT_PICO_GPIO7: J601.22; also elsewhere on the board
SUPPORT_PICO_GPIO8: J601.23; also elsewhere on the board
SUPPORT_PICO_GPIO9: J601.24; also elsewhere on the board
SUPPORT_PICO_GPIO10: J601.25; also elsewhere on the board
SUPPORT_PICO_RX_FROM_DISP: J601.7; also elsewhere on the board
SUPPORT_PICO_TX_TO_DISP: J601.6; also elsewhere on the board

Notes on the sheet:
Signal from support Pico that the side displays should be turned on
1V8 from the CM4. Not sure how useful this will ever be.
Assume 5V from the battery/USB will be swtiched on when dual shifts are pressed. The display PCB can have a LDO regulator fitted if it needs more than a few mA at 3V3.
SWD connections to the 2 Pico's programming ports
UART connection from support Pico to display Pico
Support Pico GPIOs. These are exposed on the DE-15 connector. Not sure if it's useful for the display Picos to see these.
This connector will likely be a 40-way flex cable, since that's what we've used elsewhere. The PCB this connects to is initially going to be for driving side displays, for which 40 pins is likely too many. But actually that PCB could do anything, so 40 pins might be needed.
Binary signal from support Pico, perhaps indicating which Pico is being addressed
UART connection from CM4 to display Pico
Side displays can be driven from support Pico (maybe?) so they use the support Pico's 3V3

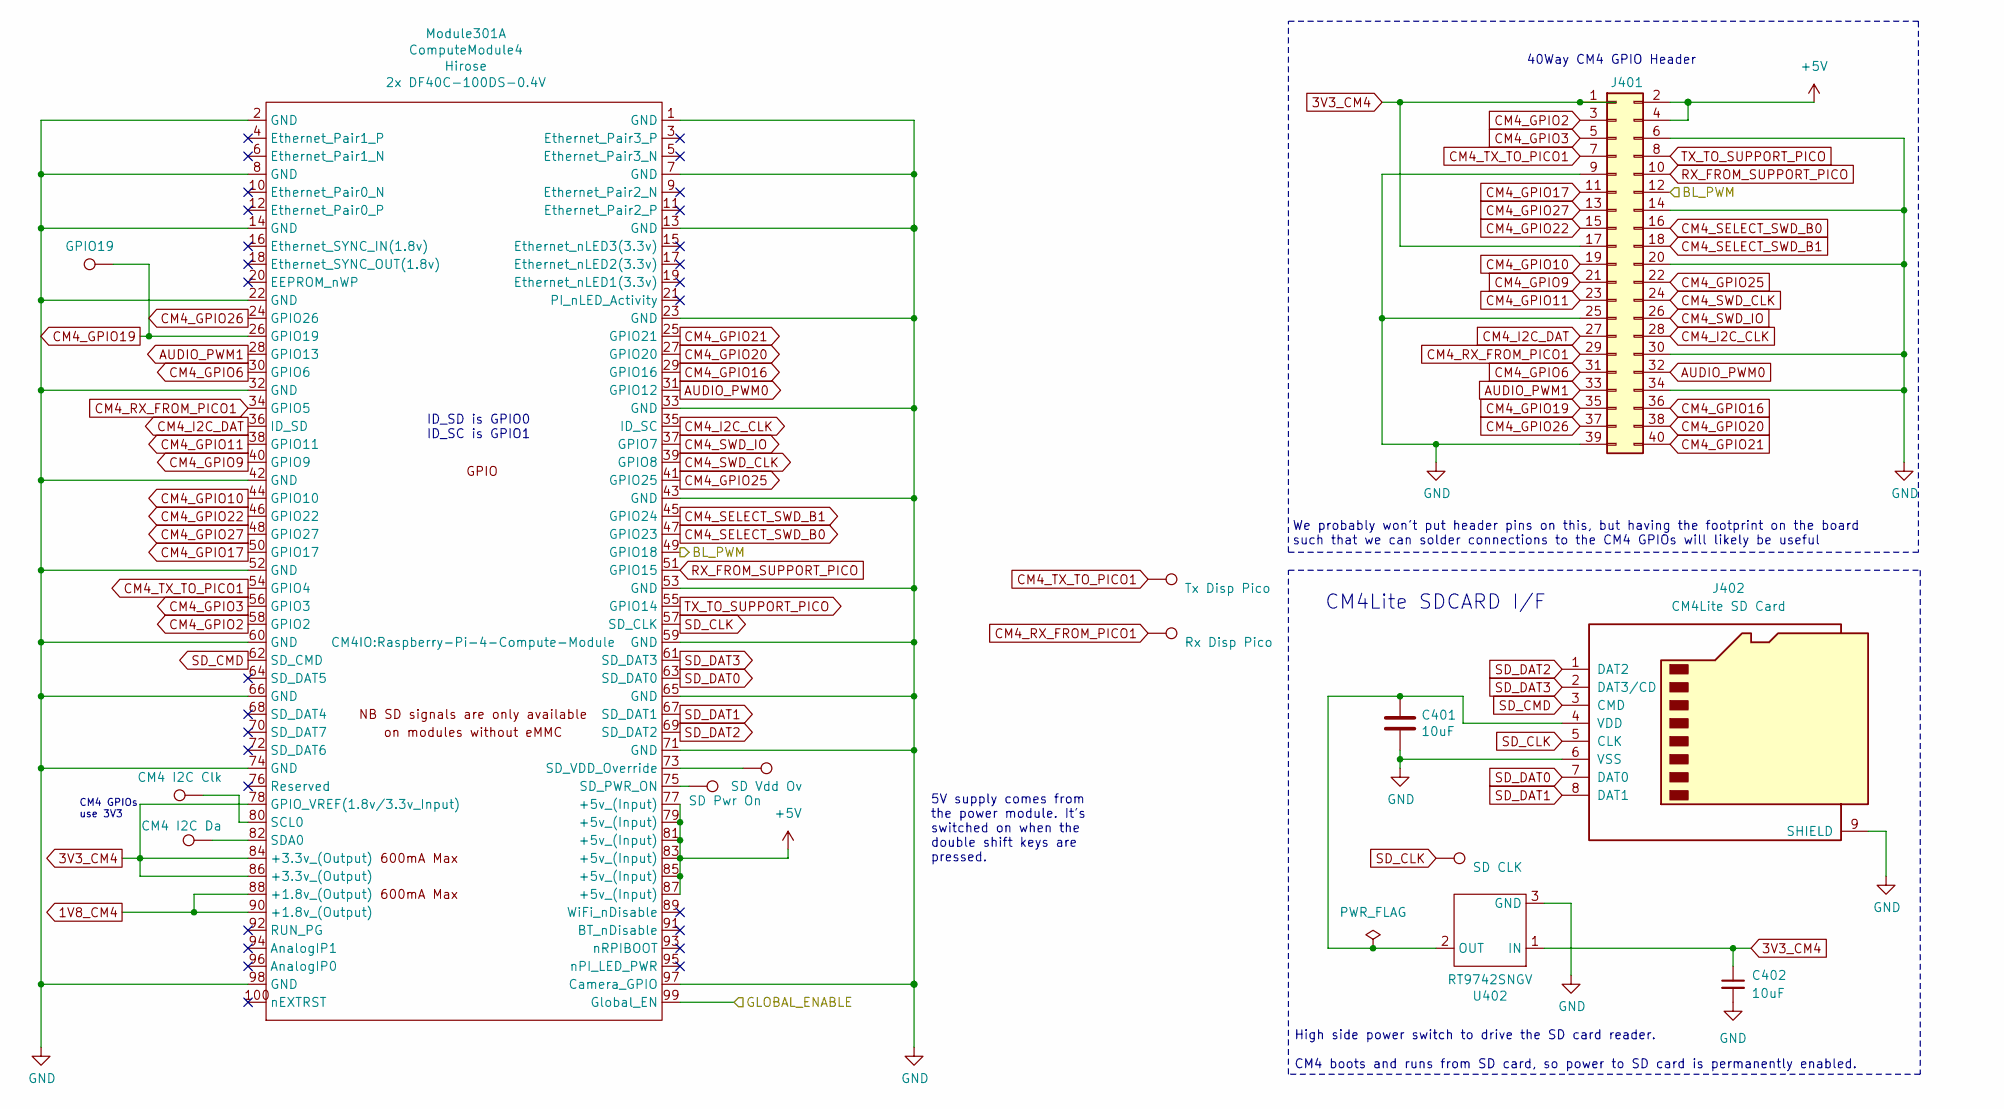
[picture p54: schematic cm4_gpio.kicad_sch, Z88R - Z88 Recreated]

Parts:
C401: 10uF; C_0805_2012Metric_Pad1.18x1.45mm_HandSolder; Part Description 10uF 10% 10V Ceramic Capacitor X7R 0805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
C402: 10uF; C_0805_2012Metric_Pad1.18x1.45mm_HandSolder
J401: PinHeader_2x20_P2.00mm_Vertical_SMD; Part Description PinHeader_2x20_P2.54mm_Vertical
J402: CM4Lite SD Card; Conn_uSDcard
Module301: ComputeModule4; Raspberry-Pi-4-Compute-Module; Part Description 100 Position Connector Receptacle, Cent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
TP401: SD Pwr On; TestPoint_THTPad_D2.0mm_Drill1.0mm
TP402: CM4 I2C Clk; TestPoint_THTPad_D2.0mm_Drill1.0mm
TP403: CM4 I2C Da; TestPoint_THTPad_D2.0mm_Drill1.0mm
TP404: SD CLK; TestPoint_THTPad_D2.0mm_Drill1.0mm
TP406: SD Vdd Ov; TestPoint_THTPad_D2.0mm_Drill1.0mm
TP408: Tx Disp Pico; TestPoint_THTPad_D2.0mm_Drill1.0mm
TP409: Rx Disp Pico; TestPoint_THTPad_D2.0mm_Drill1.0mm
TP410: GPIO19; TestPoint_THTPad_D2.0mm_Drill1.0mm
U402: RT9742SNGV; SOT-23; Part Description Power Switch/Driver 1:1 N-Channel 500mA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

Connections:
1V8_CM4: Module301.88 (+1.8v_(Output)), Module301.90 (+1.8v_(Output)); also elsewhere on the board
3V3_CM4: C402.1, J401.1, J401.17, Module301.78 (GPIO_VREF(1.8v/3.3v_Input)), Module301.84 (+3.3v_(Output)), Module301.86 (+3.3v_(Output)), U402.1 (IN); also elsewhere on the board
+5V: J401.2, J401.4, Module301.77 (+5v_(Input)), Module301.79 (+5v_(Input)), Module301.81 (+5v_(Input)), Module301.83 (+5v_(Input)), Module301.85 (+5v_(Input)), Module301.87 (+5v_(Input)); also elsewhere on the board
/CM4_GPIO/BL_PWM: J401.12, Module301.49 (GPIO18); also elsewhere on the board
/CM4_GPIO/GLOBAL_ENABLE: Module301.99 (Global_EN); also elsewhere on the board
AUDIO_PWM0: J401.32, Module301.31 (GPIO12); also elsewhere on the board
AUDIO_PWM1: J401.33, Module301.28 (GPIO13); also elsewhere on the board
CM4_GPIO2: J401.3, Module301.58 (GPIO2)
CM4_GPIO3: J401.5, Module301.56 (GPIO3)
CM4_GPIO6: J401.31, Module301.30 (GPIO6)
CM4_GPIO9: J401.21, Module301.40 (GPIO9)
CM4_GPIO10: J401.19, Module301.44 (GPIO10)
CM4_GPIO11: J401.23, Module301.38 (GPIO11)
CM4_GPIO16: J401.36, Module301.29 (GPIO16)
CM4_GPIO17: J401.11, Module301.50 (GPIO17)
CM4_GPIO19: J401.35, Module301.26 (GPIO19), TP410.1
CM4_GPIO20: J401.38, Module301.27 (GPIO20)
CM4_GPIO21: J401.40, Module301.25 (GPIO21)
CM4_GPIO22: J401.15, Module301.46 (GPIO22)
CM4_GPIO25: J401.22, Module301.41 (GPIO25)
CM4_GPIO26: J401.37, Module301.24 (GPIO26)
CM4_GPIO27: J401.13, Module301.48 (GPIO27)
CM4_I2C_CLK: J401.28, Module301.35 (ID_SC); also elsewhere on the board
CM4_I2C_DAT: J401.27, Module301.36 (ID_SD); also elsewhere on the board
CM4_RX_FROM_PICO1: J401.29, Module301.34 (GPIO5), TP409.1; also elsewhere on the board
CM4_SELECT_SWD_B0: J401.16, Module301.47 (GPIO23); also elsewhere on the board
CM4_SELECT_SWD_B1: J401.18, Module301.45 (GPIO24); also elsewhere on the board
CM4_SWD_CLK: J401.24, Module301.39 (GPIO8); also elsewhere on the board
CM4_SWD_IO: J401.26, Module301.37 (GPIO7); also elsewhere on the board
CM4_TX_TO_PICO1: J401.7, Module301.54 (GPIO4), TP408.1; also elsewhere on the board
GND: C401.2, C402.2, J401.6, J401.9, J401.14, J401.20, J401.25, J401.30, J401.34, J401.39, J402.6 (VSS), J402.9 (SHIELD), Module301.1 (GND), Module301.2 (GND), Module301.7 (GND), Module301.8 (GND), Module301.13 (GND), Module301.14 (GND), Module301.22 (GND), Module301.23 (GND), Module301.32 (GND), Module301.33 (GND), Module301.42 (GND), Module301.43 (GND), Module301.52 (GND), Module301.53 (GND), Module301.59 (GND), Module301.60 (GND), Module301.65 (GND), Module301.66 (GND), Module301.71 (GND), Module301.74 (GND), Module301.97 (Camera_GPIO), Module301.98 (GND), U402.3 (GND); also elsewhere on the board
unnamed: C401.1, J402.4 (VDD), U402.2 (OUT)
unnamed: Module301.80 (SCL0), TP402.1
unnamed: Module301.82 (SDA0), TP403.1
unnamed: Module301.75 (SD_PWR_ON), TP401.1
unnamed: Module301.73 (SD_VDD_Override), TP406.1
RX_FROM_SUPPORT_PICO: J401.10, Module301.51 (GPIO15); also elsewhere on the board
SD_CLK: J402.5 (CLK), Module301.57 (SD_CLK), TP404.1
SD_CMD: J402.3 (CMD), Module301.62 (SD_CMD)
SD_DAT0: J402.7 (DAT0), Module301.63 (SD_DAT0)
SD_DAT1: J402.8 (DAT1), Module301.67 (SD_DAT1)
SD_DAT2: J402.1 (DAT2), Module301.69 (SD_DAT2)
SD_DAT3: J402.2 (DAT3/CD), Module301.61 (SD_DAT3)
TX_TO_SUPPORT_PICO: J401.8, Module301.55 (GPIO14); also elsewhere on the board

Notes on the sheet:
CM4 GPIOs use 3V3
High side power switch to drive the SD card reader. CM4 boots and runs from SD card, so power to SD card is permanently enabled.
CM4Lite SDCARD I/F
ID_SD is GPIO0 ID_SC is GPIO1
5V supply comes from the power module. It's switched on when the double shift keys are pressed.
40Way CM4 GPIO Header
We probably won't put header pins on this, but having the footprint on the board such that we can solder connections to the CM4 GPIOs will likely be useful

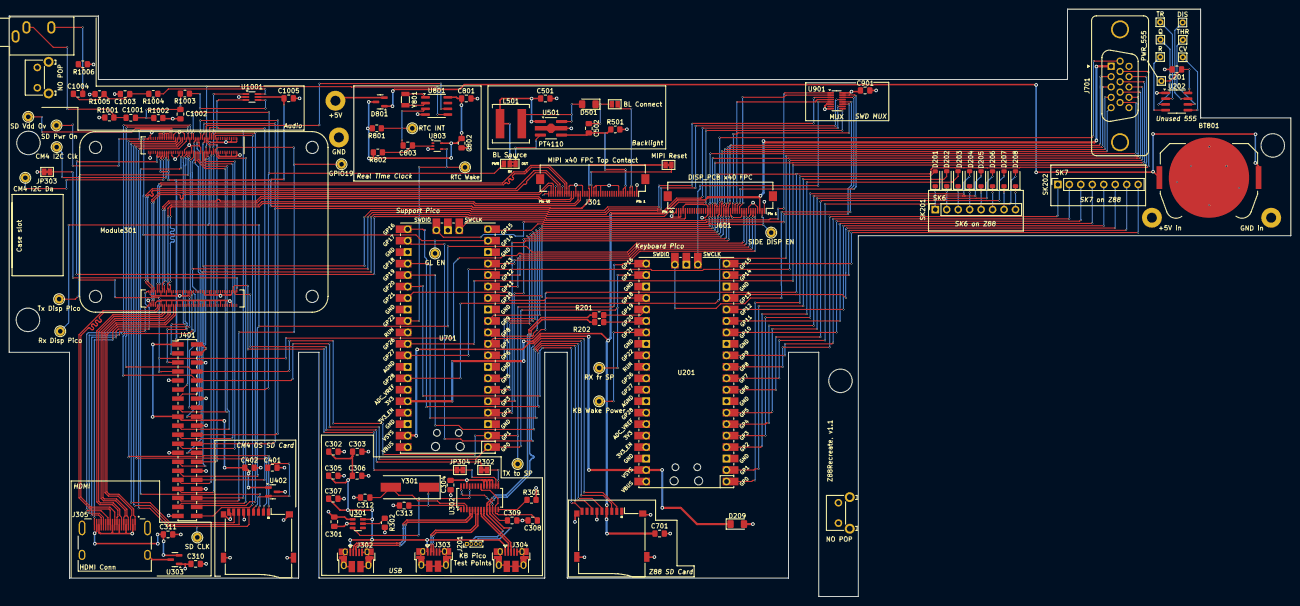
[picture p55: board z88_new.kicad_pcb from above]

Board: 4 copper layers, 283.9 x 130.1 mm, 117 parts (0 on the bottom side), 173 nets.
