derekfountain/z88-recreation/software/application-board/app-board-demo-ssd1306-oled/oled_display.c

/*
 * ZX Pico IF1 Firmware, a Raspberry Pi Pico based ZX Interface One emulator
 * Copyright (C) 2023 Derek Fountain
 * 
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
 * You should have received a copy of the GNU General Public License
 * along with this program; if not, write to the Free Software
 * Foundation, Inc., 51 Franklin Street, Fifth Floor, Boston, MA  02110-1301, USA.
 */

#include "ssd1306.h"

#include "oled_display.h"
#include <stdio.h>

ssd1306_t display;

#define OLED_I2C    (i2c0)
#define OLED_FREQ   400000
#define OLED_WIDTH  128
#define OLED_HEIGHT 64
#define OLED_ADDR   0x3C
#define OLED_SCK    21
#define OLED_SDA    20

void oled_display_init( void )
{
  i2c_init(OLED_I2C, OLED_FREQ);
  gpio_set_function( OLED_SCK, GPIO_FUNC_I2C ); gpio_pull_up( OLED_SCK );
  gpio_set_function( OLED_SDA, GPIO_FUNC_I2C ); gpio_pull_up( OLED_SDA );
  display.external_vcc=false;

  ssd1306_init( &display, OLED_WIDTH, OLED_HEIGHT, OLED_ADDR, OLED_I2C );
  ssd1306_clear( &display );

  return;
}

void oled_update( void )
{
  ssd1306_show(&display);
}

void oled_clear( void )
{
  ssd1306_clear( &display );
}

void oled_draw_xs( void )
{
  ssd1306_draw_string( &display, 0, 48, 1, "Z", 0 );
}
