derekfountain/z88-recreation/(commit log)

2025-11-17 add keyboard prototype
2025-11-17 remove large video from prototype
2025-11-17 add early 3D print bits and pieces
    [display_mount.3mf, display_mount.scad, display_mount.stl, display_mount_two_side_displays.3mf, display_mount_two_side_displays.scad, display_mount_two_side_displays.stl, eemb.scad, eemb_103395.stl]
2025-11-17 add the support pico software directory with the uart test case
2025-11-18 add support pico's SD card reader example
2025-11-18 add a RTC->Support Pico timer signal test
2025-11-21 add support pico to CM4 signal example
2025-11-21 add application board mountings 3d print
    [application_board_mount.3mf, application_board_mount.scad, application_board_mount.stl]
2025-12-02 add early version of application board
    [app_board.kicad_pcb, app_board.kicad_sch, z88r_connection.kicad_sch]
2025-12-04 start layout of application board
    [app_board.kicad_pcb, z88r_connection.kicad_sch]
2025-12-04 more layout work
    [app_board.kicad_pcb, app_board.kicad_sch, z88r_connection.kicad_sch]
2025-12-06 layout complete, first draft, needs tidying
    [app_board.kicad_pcb]
2025-12-06 fab1.0 off to JLC
    [app_board-B_Cu.gbl, app_board-B_Mask.gbs, app_board-B_Paste.gbp, app_board-B_Silkscreen.gbo, app_board-Edge_Cuts.gm1, app_board-F_Cu.gtl, app_board-F_Mask.gts, app_board-F_Paste.gtp]
2025-12-08 start v1.1, missed some tidyups and a label
    [app_board.kicad_pcb]
2025-12-18 update block diagram with current thinking and power domains
2025-12-29 start next board iteration, add latch and pico power bits
    [audio.kicad_sch, cm4_gpio.kicad_sch, cm4_highspeed.kicad_sch, displays.kicad_sch, keyboard.kicad_sch, picos_latch.kicad_sch, power.kicad_sch, rtc.kicad_sch]
2025-12-29 CM4 power switch
    [cm4_gpio.kicad_sch, power.kicad_sch, support_pico.kicad_sch]
2025-12-30 add i2c connection to the support pico so it can control the RTC
    [cm4_gpio.kicad_sch, rtc.kicad_sch, support_pico.kicad_sch]
2025-12-30 turn the KB diodes round, oops
    [keyboard.kicad_sch, support_pico.kicad_sch]
2025-12-30 make a start on RP2040 to replace the KB pico
    [audio.kicad_sch, cm4_gpio.kicad_sch, cm4_highspeed.kicad_sch, displays.kicad_sch, kb_rp2040.kicad_sch, keyboard.kicad_sch, picos_latch.kicad_sch, power.kicad_sch]
2025-12-30 more work on KB pico replacement
    [kb_rp2040.kicad_sch, swdmux.kicad_sch]
2025-12-31 more working out of the KB pico replacement
    [kb_rp2040.kicad_sch, keyboard.kicad_sch, power.kicad_sch, rtc.kicad_sch, support_pico.kicad_sch, swdmux.kicad_sch, z88_new.kicad_sch]
2026-01-01 start the support pico rp2040 replacement
    [audio.kicad_sch, cm4_gpio.kicad_sch, cm4_highspeed.kicad_sch, displays.kicad_sch, kb_rp2040.kicad_sch, keyboard.kicad_sch, picos_latch.kicad_sch, power.kicad_sch]
2026-01-01 rename the pico bits to RP2040, still a few things to check
    [displays.kicad_sch, kb_rp2040.kicad_sch, support_pico.kicad_sch, z88_new.kicad_sch]
2026-01-01 a few more tidyups, almost ready for dual shifts stuff now
    [displays.kicad_sch, kb_rp2040.kicad_sch, keyboard.kicad_sch, picos_latch.kicad_sch, power.kicad_sch, support_pico.kicad_sch]
2026-01-01 more support rp2040 cleanups
    [cm4_gpio.kicad_sch, displays.kicad_sch, kb_rp2040.kicad_sch, power.kicad_sch, support_pico.kicad_sch]
2026-01-04 start v1.1 pcb, add FPC connector label
    [app_board.kicad_pcb, app_board.kicad_sch, z88r_connection.kicad_sch]
2026-01-08 add support pico utility to activate the application board
2026-01-09 add the ELF version of the keyboard software, this is required to reprogram the pico via SWD
2026-01-09 application board blink example
2026-01-27 increase height of application board mount by 1mm
    [application_board_mount.3mf, application_board_mount.scad, application_board_mount.stl]
2026-01-28 change activate app board to remove the blink
2026-01-30 start a SSD1306 app board example, not sure what chip my displays are using
2026-02-02 fix my SH1106 code, my screens have an offset
    [app_board_demo_oled.c, sh1106.c, sh1106.h]
2026-02-04 add top bezel for the 1.3inch side screen
    [top_bezel_1_3i.3mf, top_bezel_1_3i.scad, top_bezel_1_3i.stl]
2026-02-04 add the 1.3inch oled lower bezel
    [bottom_bezel_1_3i.3mf, bottom_bezel_1_3i.scad, bottom_bezel_1_3i.stl]
2026-02-04 add a pause in the application board pico code for the i2c bus to get going
2026-02-12 update support pico links: UART0 to CM4, UART1 to app board Pico0, GPIOs to app board Pico1. KB pico outstanding
    [displays.kicad_sch, support_pico.kicad_sch]
2026-02-12 disconnect the keyboard pico from the support pico, that link isn't required
    [support_pico.kicad_sch]
2026-02-12 add note about support Pico to application board pico1
2026-02-12 rename display board things to application board things
    [cm4_gpio.kicad_sch, displays.kicad_sch, support_pico.kicad_sch, z88_new.kicad_sch]
2026-02-12 more renaming and tidying up of internal interfaces
    [displays.kicad_sch, support_pico.kicad_sch, z88_new.kicad_sch]
2026-02-13 tidy the keyboard comms
    [displays.kicad_sch, kb_rp2040.kicad_sch, support_pico.kicad_sch, swdmux.kicad_sch]
2026-02-13 rename app board picos to 1 and 2, to match the application board schematics
    [cm4_gpio.kicad_sch, displays.kicad_sch, kb_rp2040.kicad_sch, support_pico.kicad_sch, swdmux.kicad_sch]
2026-02-13 rename CM4 to support RP link
    [cm4_gpio.kicad_sch, support_pico.kicad_sch]
2026-02-13 move an SWD GPIO freeing up UART4 on the CM4. use that for talking to the appb Pico2
    [cm4_gpio.kicad_sch, displays.kicad_sch]
2026-02-13 oops, missed a couple of references to GPIOs i'd changed
    [cm4_gpio.kicad_sch]
2026-02-15 start the firmware for the support pico, for the v1.0 board
2026-03-18 establish a hello_world UART connection from main board to app board pico
2026-03-19 update strings sent from support to left pico, looks more sensible even if it's not
2026-03-19 add an application for Pico2 on the application board
