derekfountain/z88-recreation/(notices)

Notices in the files:
software/application-board/app-board-demo-ssd1306-oled/oled_display.c:
modify it under the terms of the GNU General Public License
